meetsitaram/reindeer/reports/fusion/fusion_back.png

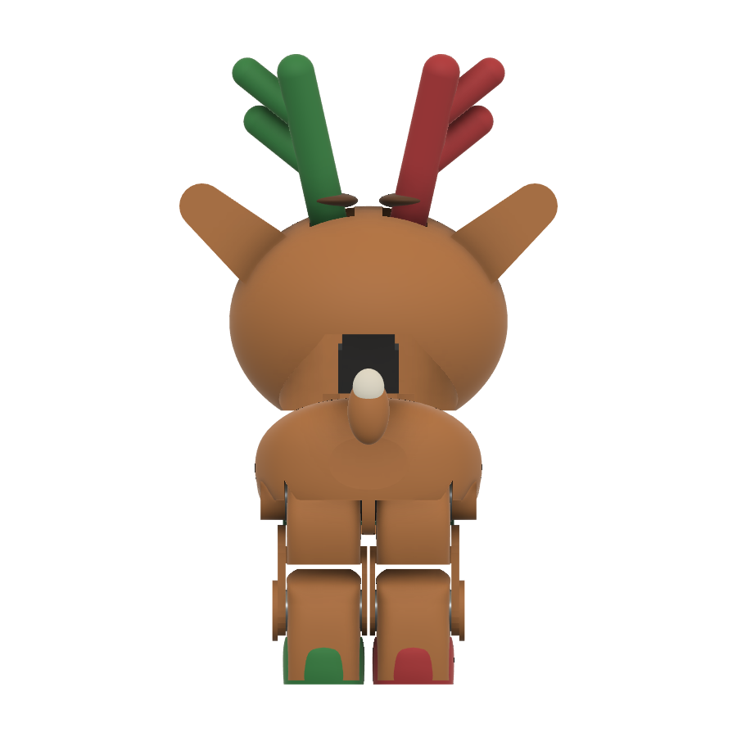
reports/fusion/fusion_back.png
