meetsitaram/reindeer/reports/fusion/fusion_pose_r34.png

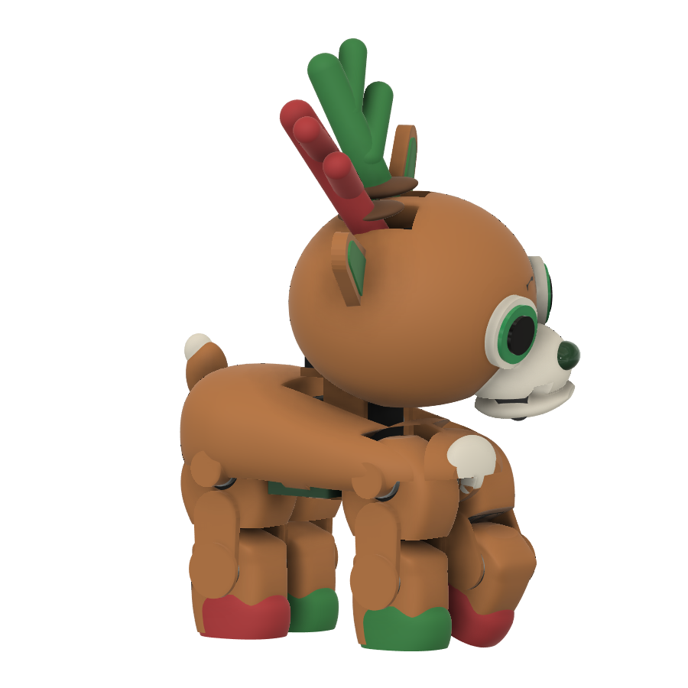
reports/fusion/fusion_pose_r34.png
