meetsitaram/reindeer/reports/fusion/fusion_r34.png

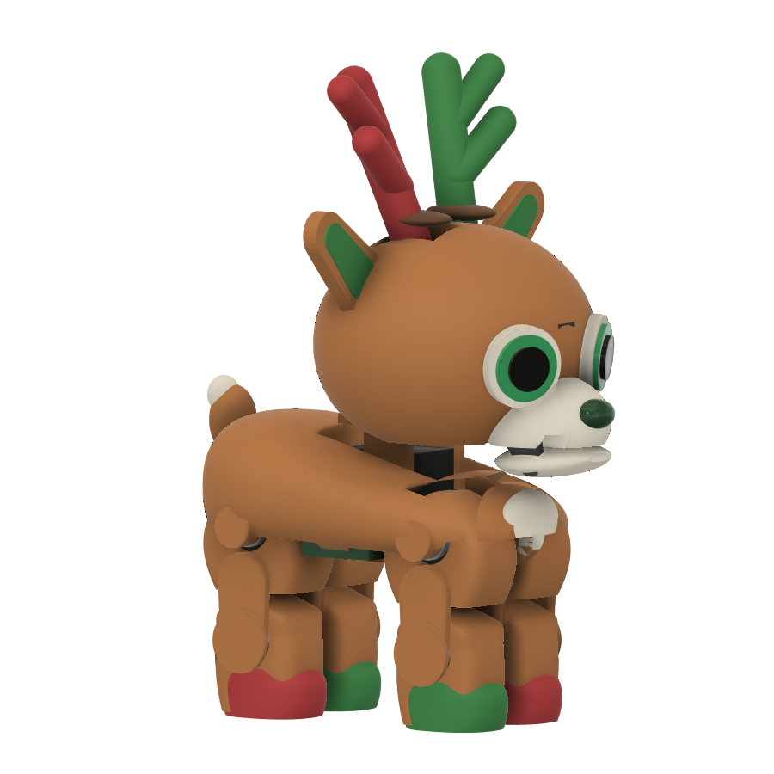
reports/fusion/fusion_r34.png
