meetsitaram/reindeer/reports/fusion/fusion_side.png

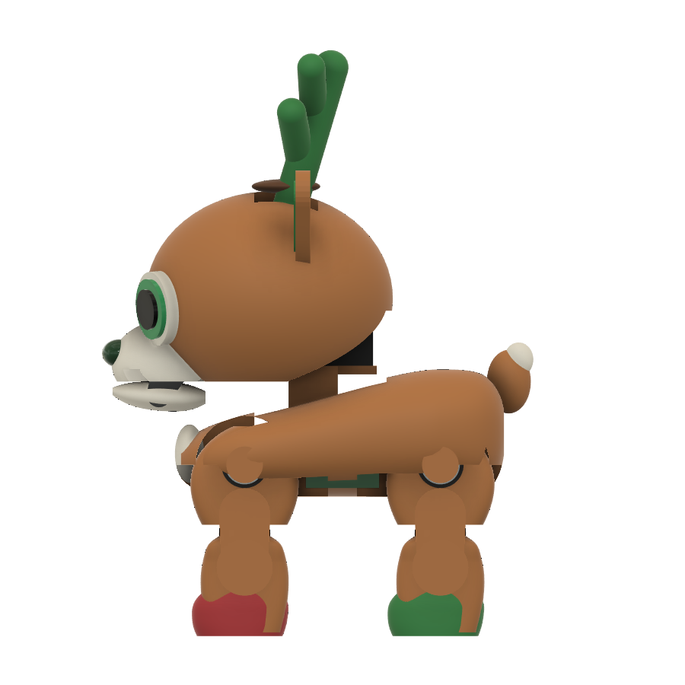
reports/fusion/fusion_side.png
