meetsitaram/reindeer/reports/fusion/fusion_top.png

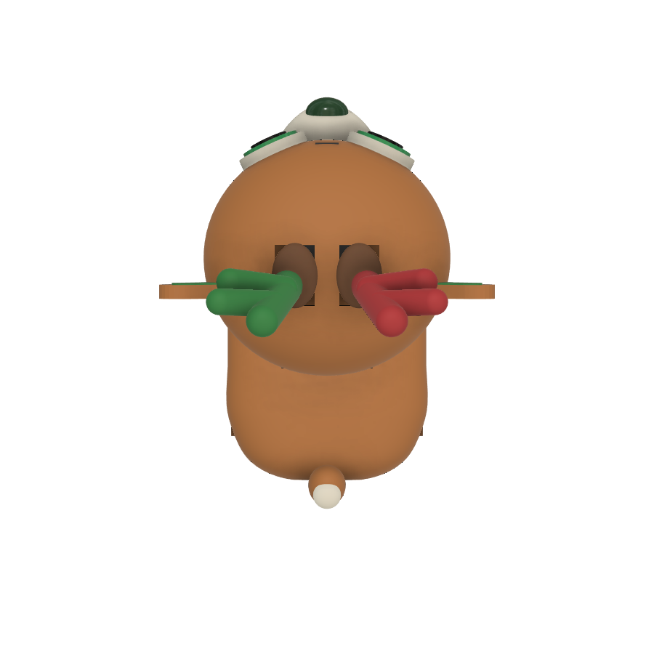
reports/fusion/fusion_top.png
