meetsitaram/reindeer/reports/motion_frames/all.png

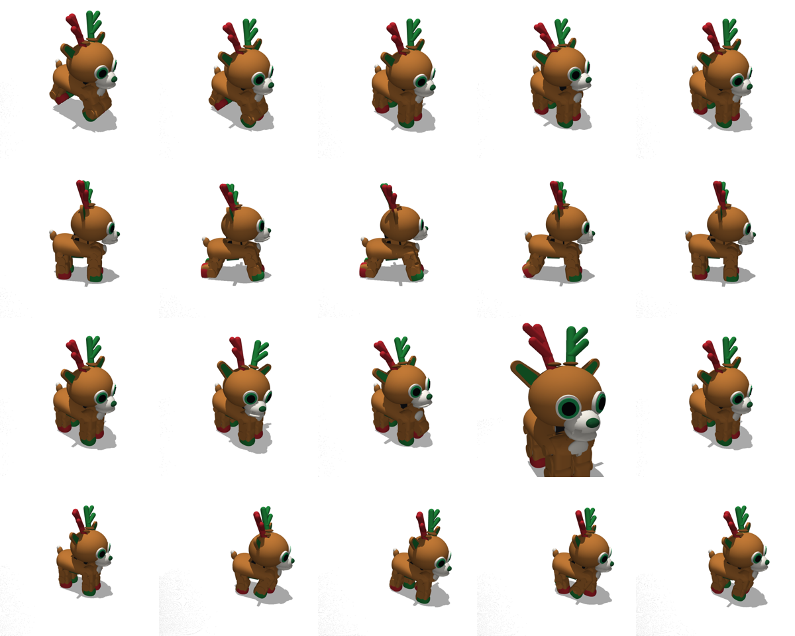
reports/motion_frames/all.png
