meetsitaram/reindeer/reports/motion_frames/motions.png

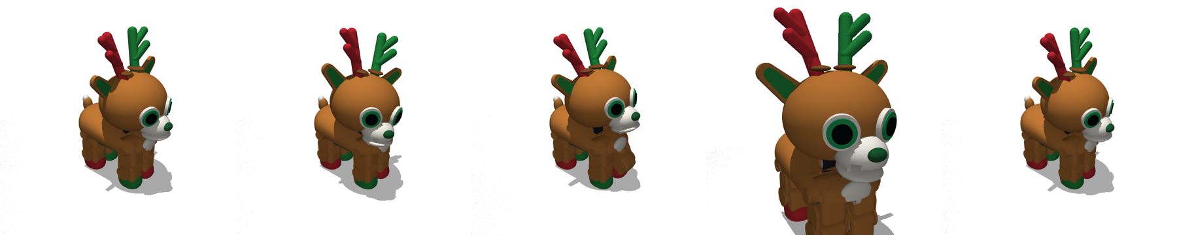
reports/motion_frames/motions.png
