meetsitaram/reindeer/reports/motion_frames/sit.png

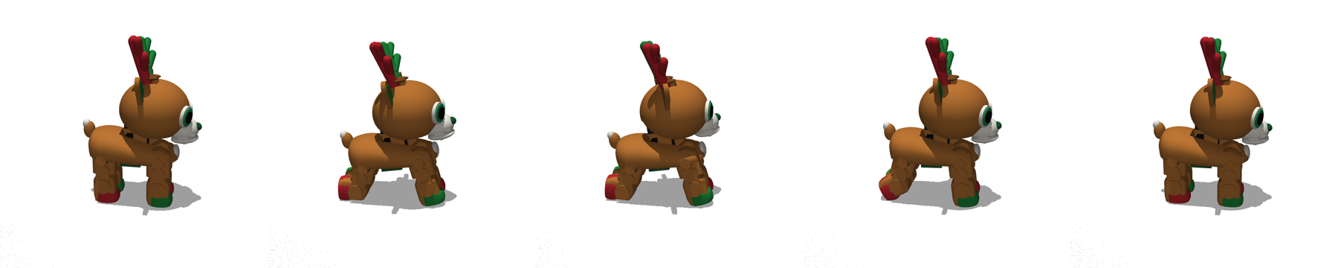
reports/motion_frames/sit.png
