meetsitaram/reindeer/reports/motion_frames/stand_up.png

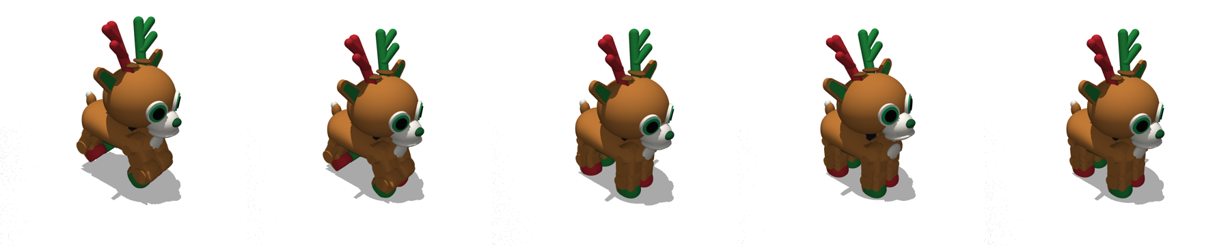
reports/motion_frames/stand_up.png
