meetsitaram/reindeer/reports/motion_frames/walk.png

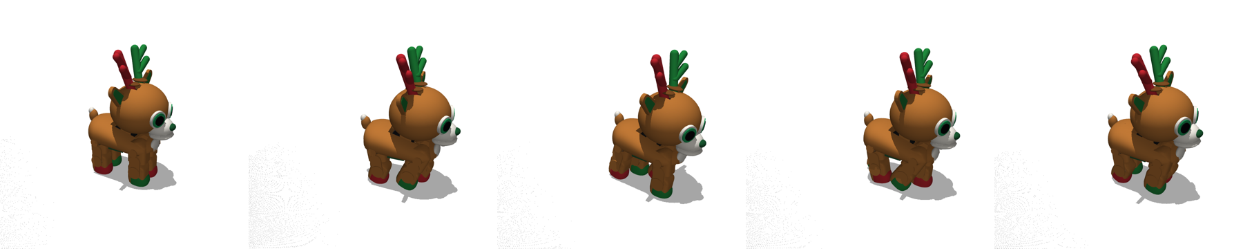
reports/motion_frames/walk.png
