meetsitaram/reindeer/reports/poses.png

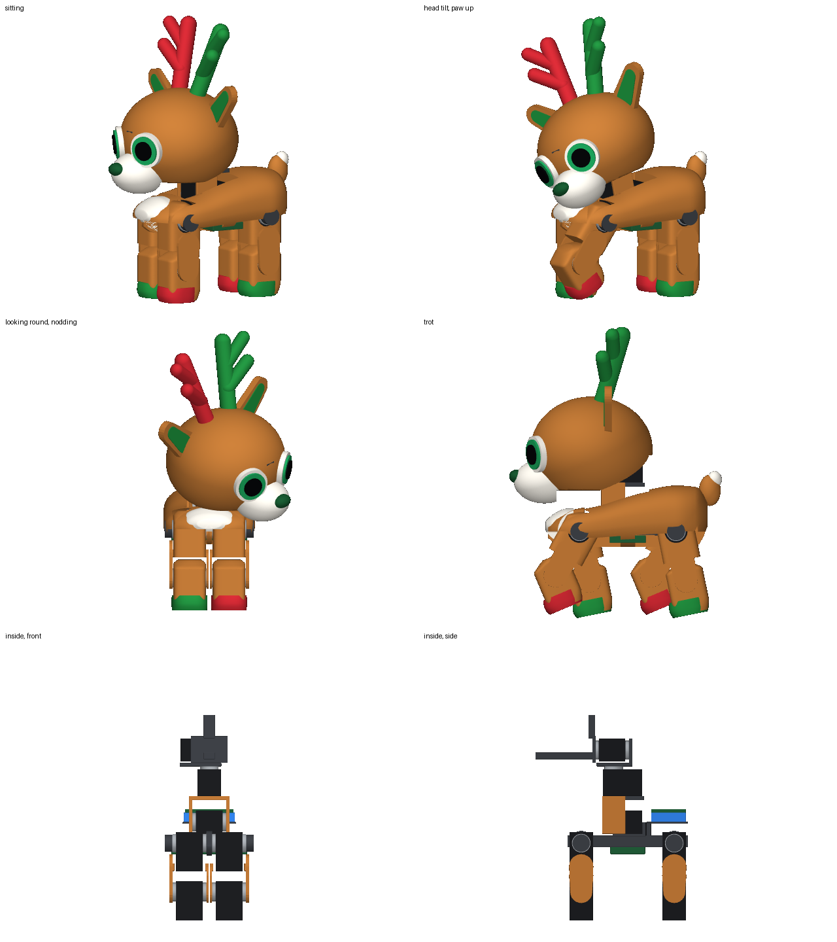
reports/poses.png
