meetsitaram/reindeer/reports/round8.png

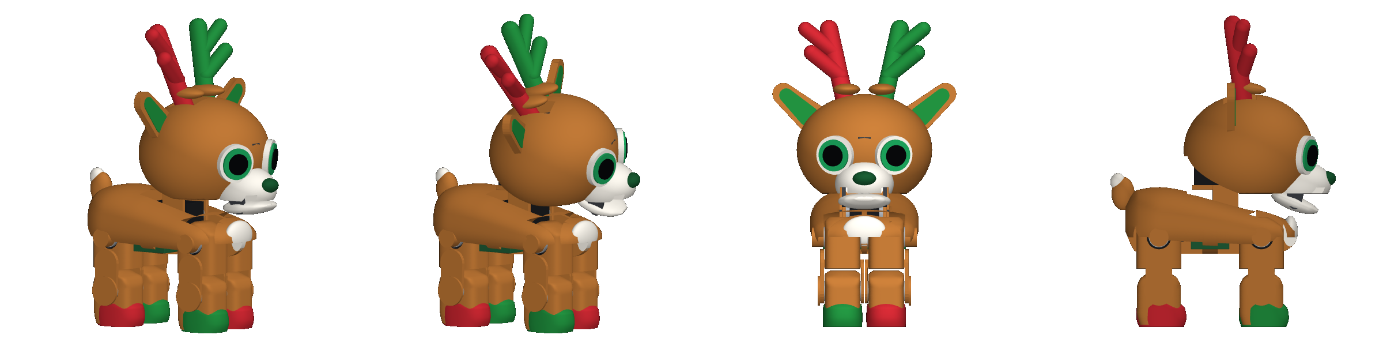
reports/round8.png
