meetsitaram/reindeer/docs/parts_layout.png

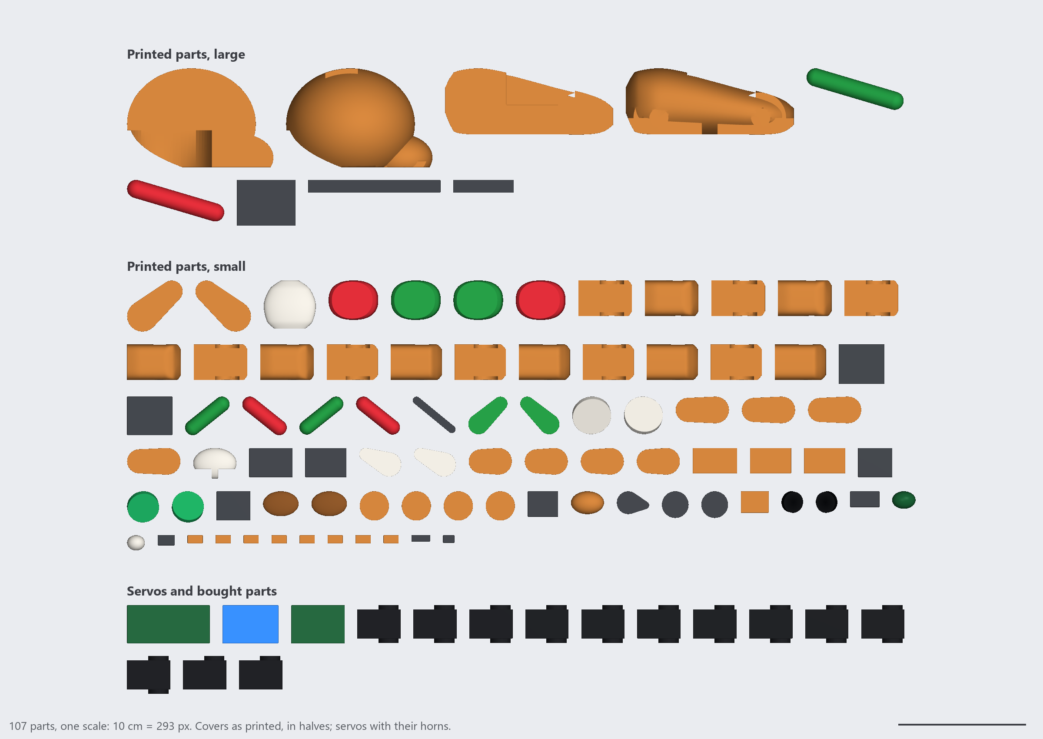
docs/parts_layout.png
