meetsitaram/reindeer/cad/reindeer.step

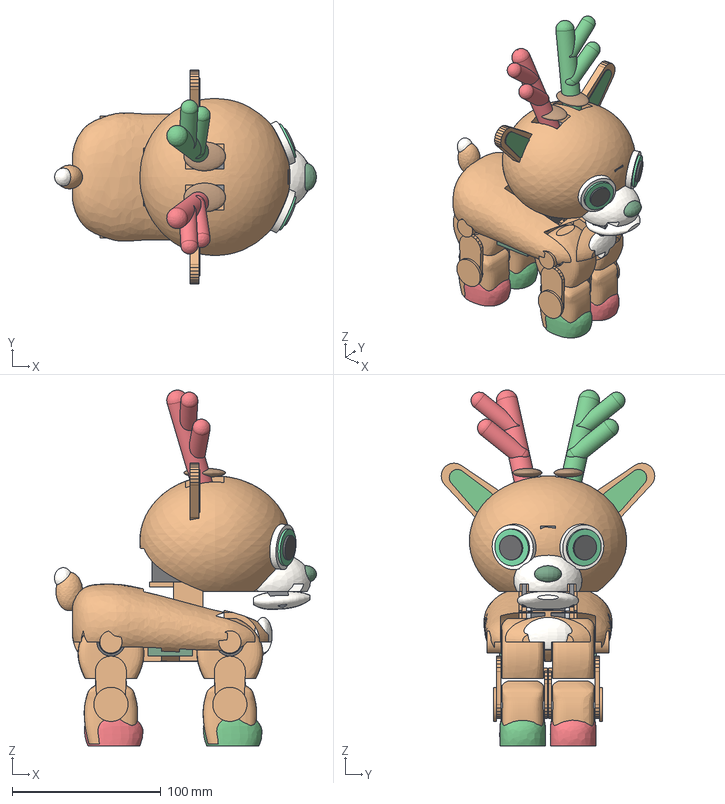
[picture p14: CAD file, 2026-11-06]
cad/reindeer.step
176.3 x 143.8 x 239.5 mm
