meetsitaram/reindeer/prints/antlers/antler_horn_plate.stl

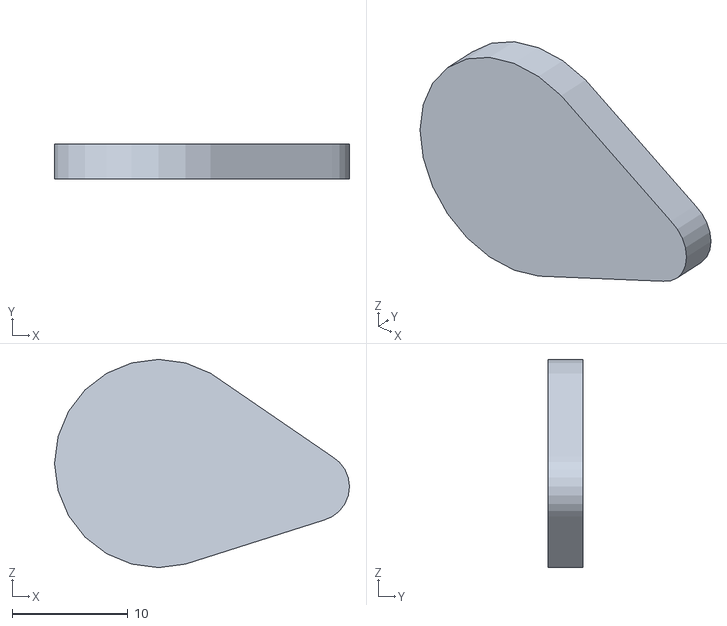
[picture p15: CAD file, 2026-11-06]
prints/antlers/antler_horn_plate.stl
25.5 x 3.00 x 18.0
