meetsitaram/reindeer/prints/body/bib.stl

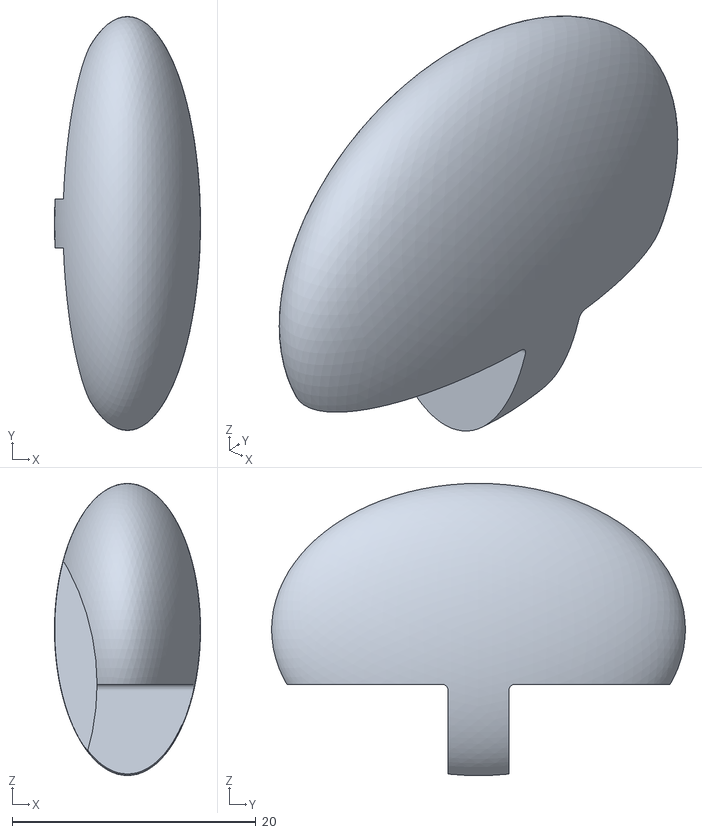
[picture p16: CAD file, 2026-11-06]
prints/body/bib.stl
12.0 x 34.0 x 24.0
