meetsitaram/reindeer/prints/head/head_face_post.stl

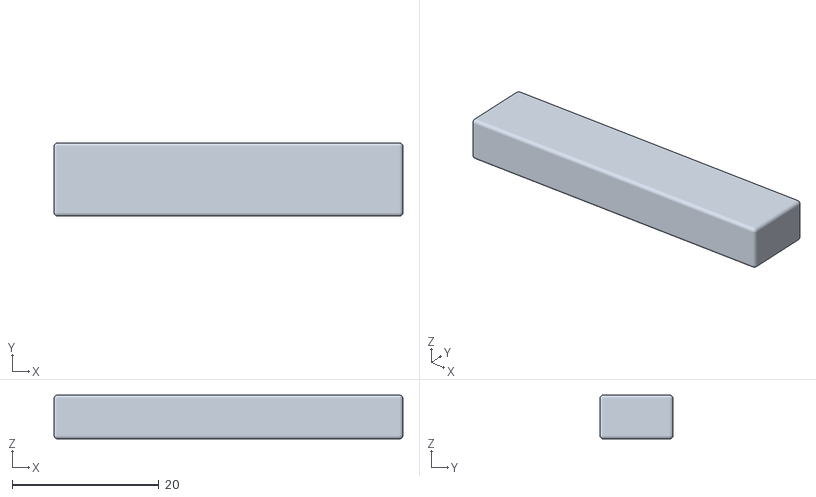
[picture p17: CAD file, 2026-11-06]
prints/head/head_face_post.stl
47.6 x 10.0 x 6.00
