meetsitaram/reindeer/prints/jaw/R_jaw_plate.stl

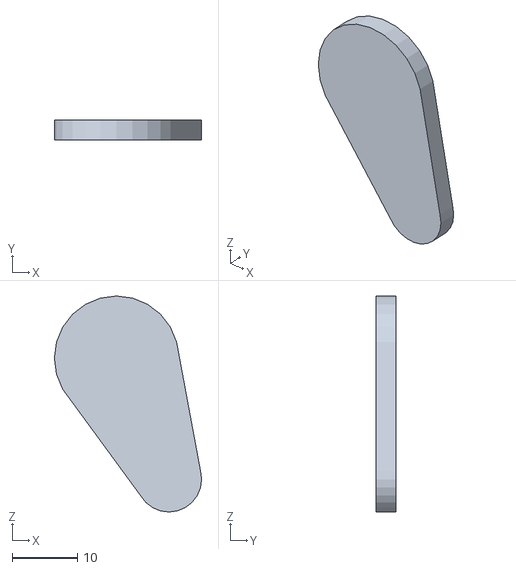
[picture p18: CAD file, 2026-11-06]
prints/jaw/R_jaw_plate.stl
22.5 x 3.00 x 33.0
