meetsitaram/reindeer/prints/L_front_shin/L_front_shin.stl

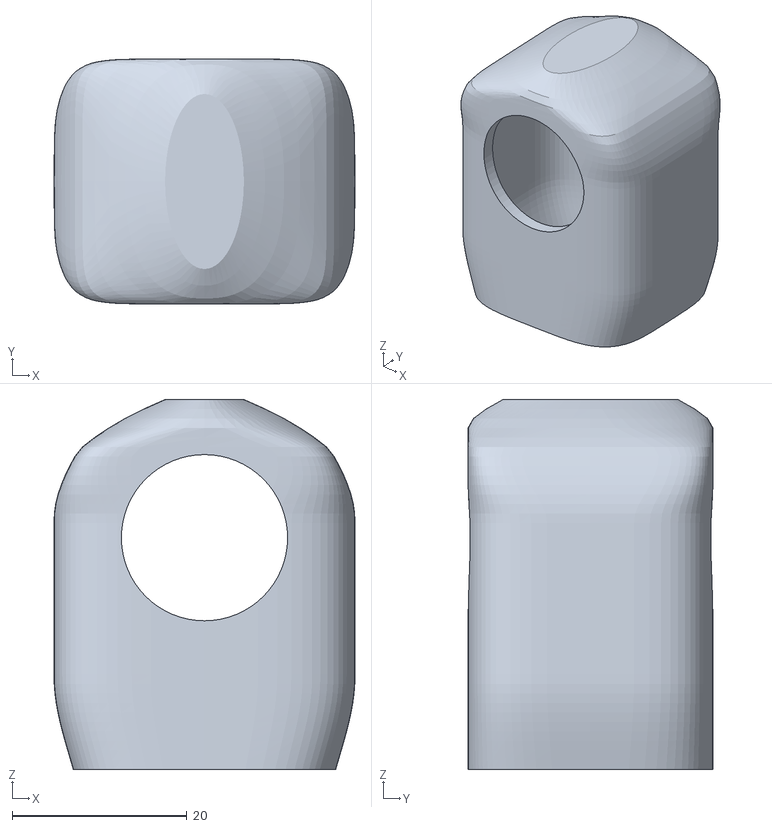
[picture p19: CAD file, 2026-11-06]
prints/L_front_shin/L_front_shin.stl
34.4 x 28.0 x 42.3
