meetsitaram/reindeer/prints/L_front_thigh/L_front_knee_plate.stl

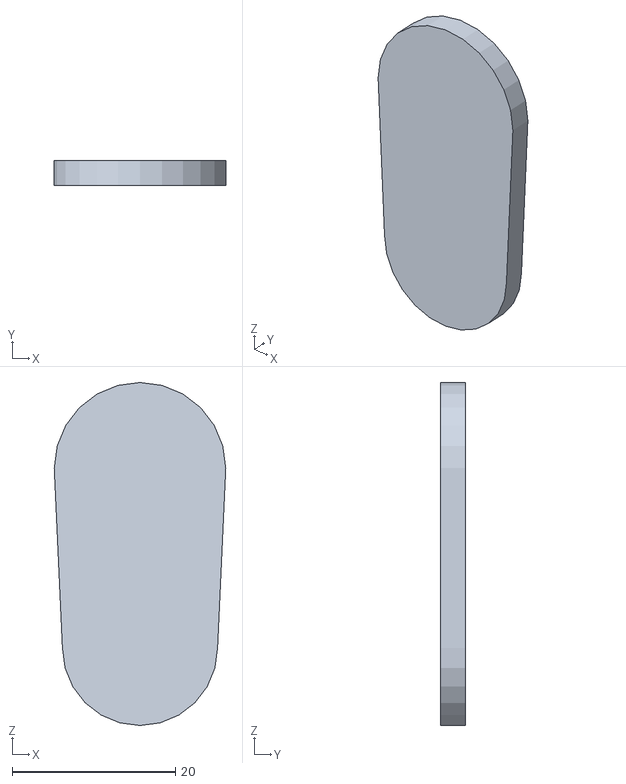
[picture p20: CAD file, 2026-11-06]
prints/L_front_thigh/L_front_knee_plate.stl
21.0 x 3.00 x 42.0
