meetsitaram/reindeer/prints/neck/neck_yaw_seat.stl

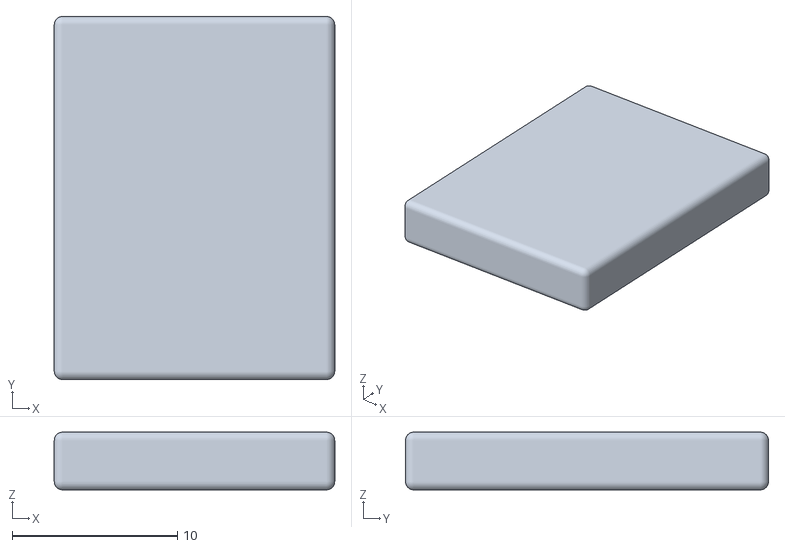
[picture p21: CAD file, 2026-11-06]
prints/neck/neck_yaw_seat.stl
17.0 x 22.0 x 3.50
