meetsitaram/reindeer/prints/R_front_thigh/R_front_thigh.stl

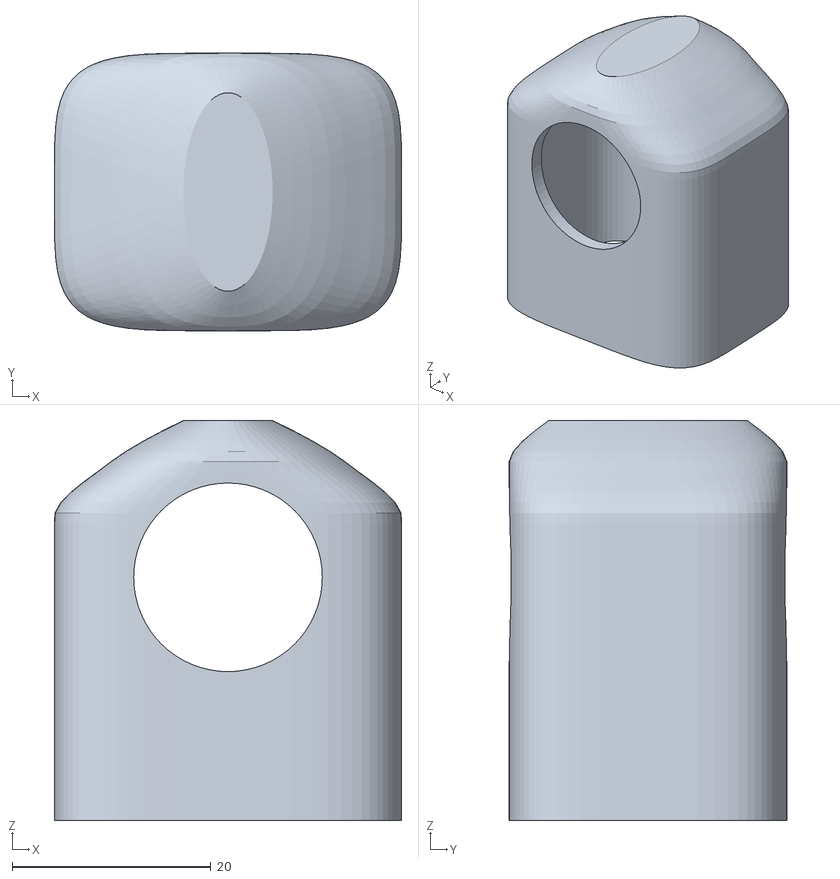
[picture p22: CAD file, 2026-11-06]
prints/R_front_thigh/R_front_thigh.stl
35.0 x 28.0 x 40.3
