meetsitaram/reindeer/prints/R_rear_shin/R_rear_hoof.stl

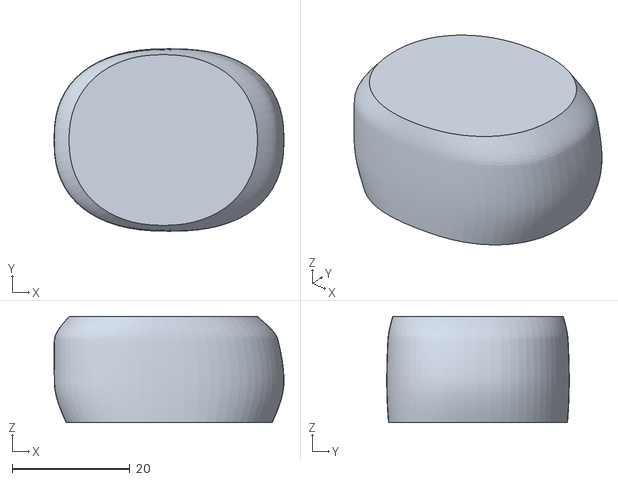
[picture p23: CAD file, 2026-11-06]
prints/R_rear_shin/R_rear_hoof.stl
39.0 x 31.0 x 18.0
