meetsitaram/reindeer/prints/R_rear_thigh/R_rear_knee_outer_tab.stl

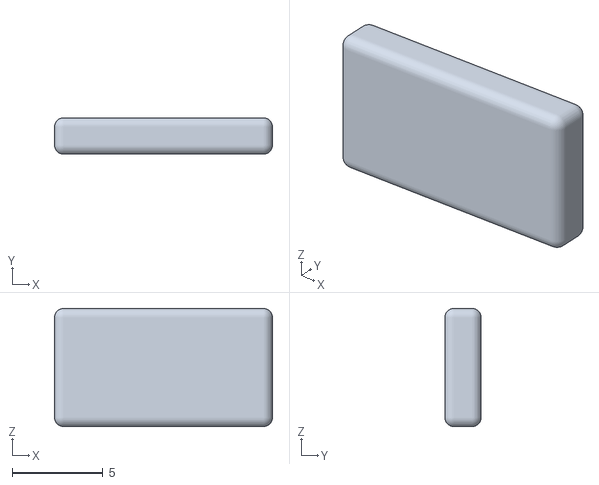
[picture p24: CAD file, 2026-11-06]
prints/R_rear_thigh/R_rear_knee_outer_tab.stl
12.0 x 2.00 x 6.50
