meetsitaram/reindeer/prints/yawlink/roll_rear_wall.stl

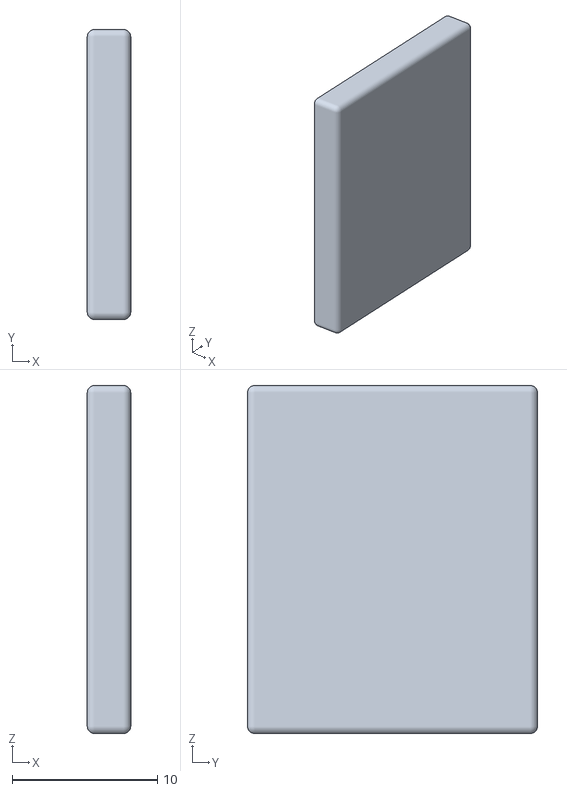
[picture p25: CAD file, 2026-11-06]
prints/yawlink/roll_rear_wall.stl
3.00 x 20.0 x 24.0
