meetsitaram/reindeer/prints/antlers/antler_bar_arm.stl

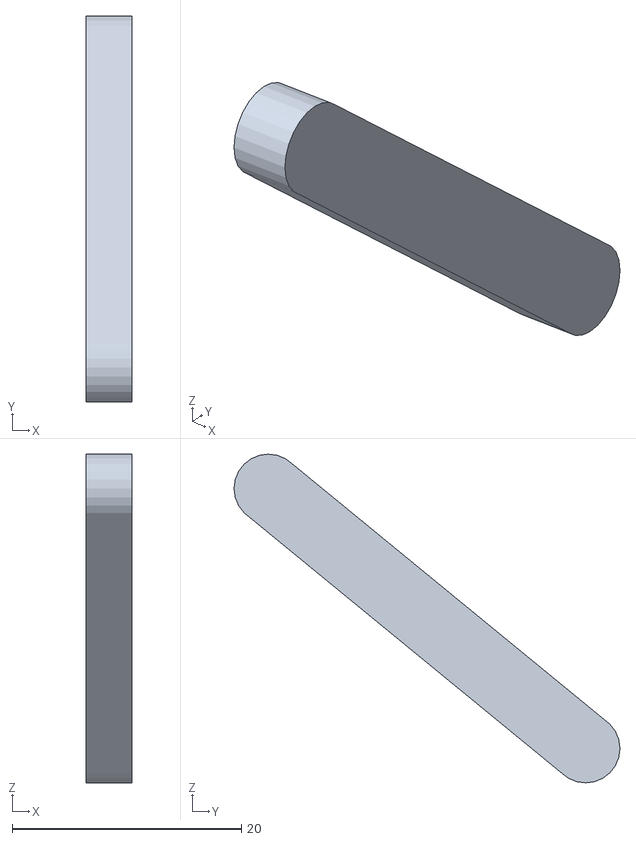
[picture p26: CAD file, 2026-11-06]
prints/antlers/antler_bar_arm.stl
4.00 x 33.7 x 28.7
