meetsitaram/reindeer/prints/body/R_front_hip_boss.stl

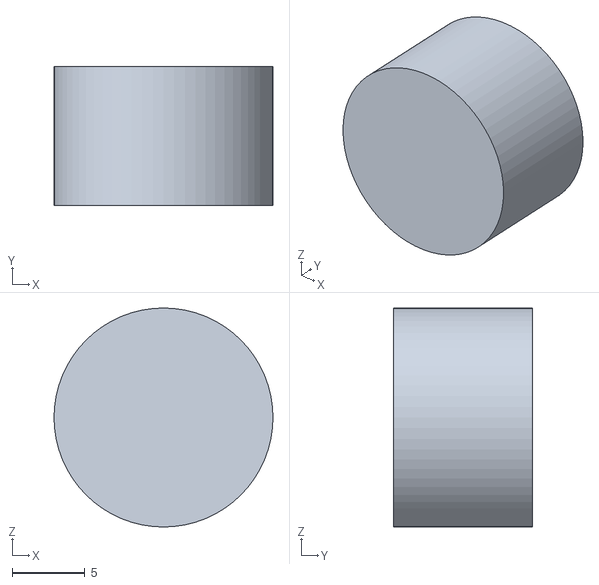
[picture p27: CAD file, 2026-11-06]
prints/body/R_front_hip_boss.stl
15.0 x 9.50 x 15.0
