meetsitaram/reindeer/prints/head/L_ear.stl

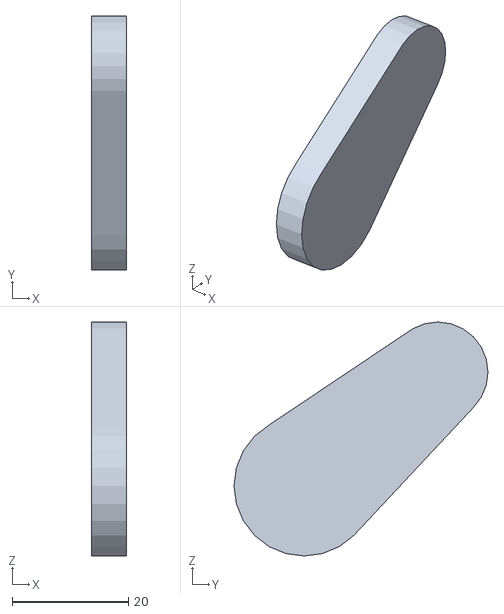
[picture p28: CAD file, 2026-11-06]
prints/head/L_ear.stl
6.00 x 43.7 x 40.3
