meetsitaram/reindeer/prints/jaw/jaw.stl

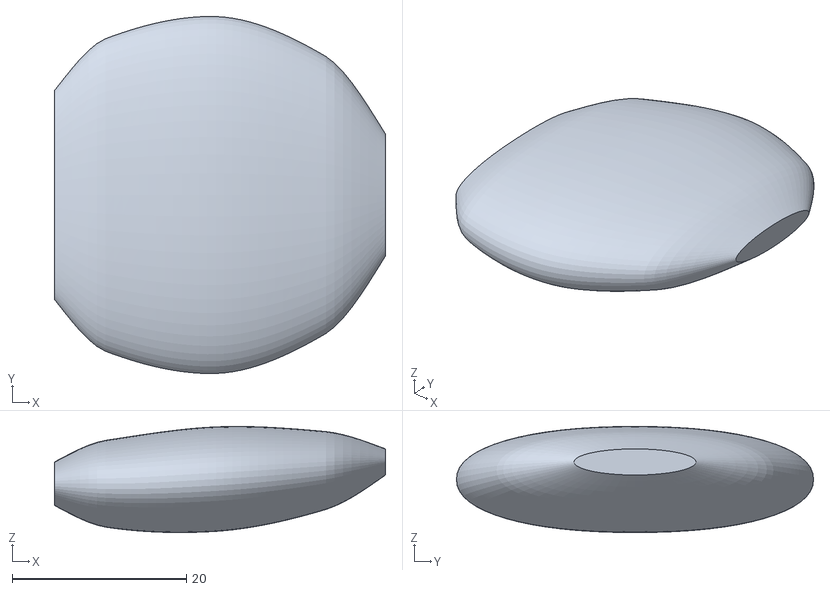
[picture p29: CAD file, 2026-11-06]
prints/jaw/jaw.stl
38.0 x 41.0 x 12.2
