meetsitaram/reindeer/prints/L_front_thigh/L_front_knee_inner_tab.stl

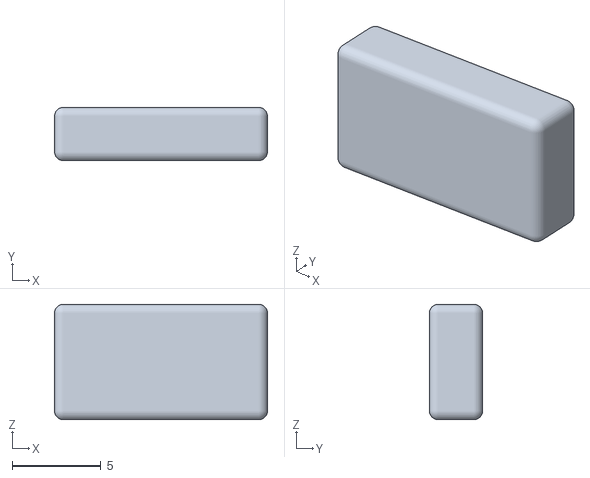
[picture p30: CAD file, 2026-11-06]
prints/L_front_thigh/L_front_knee_inner_tab.stl
12.0 x 3.00 x 6.50
