meetsitaram/reindeer/prints/neck/neck_bridge.stl

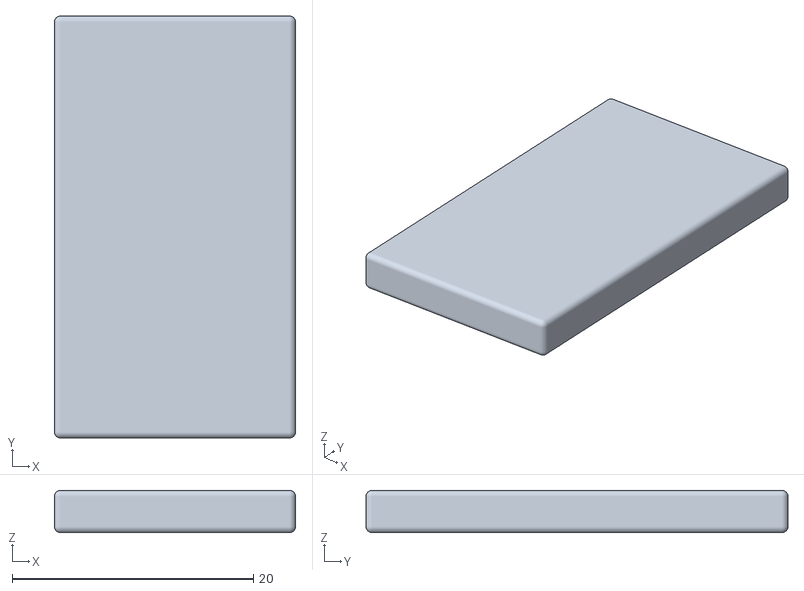
[picture p31: CAD file, 2026-11-06]
prints/neck/neck_bridge.stl
20.0 x 35.0 x 3.50
