meetsitaram/reindeer/prints/yawlink/yaw_plate.stl

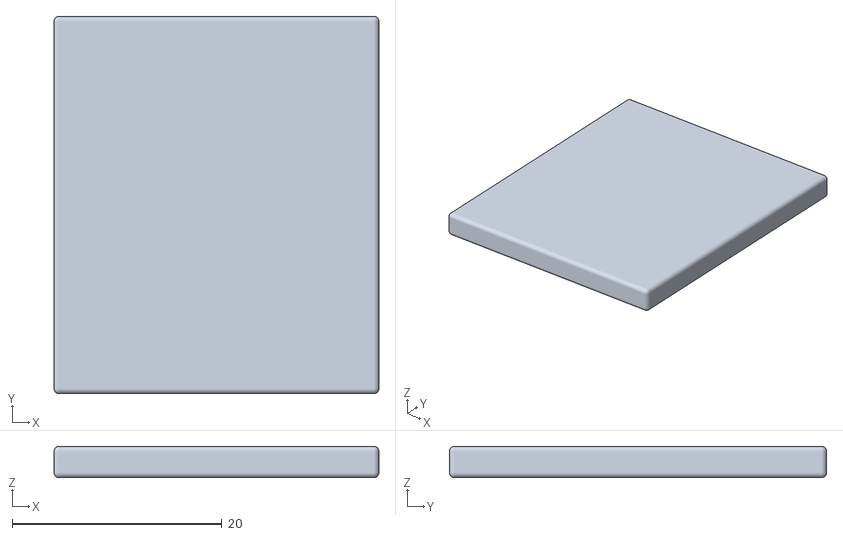
[picture p32: CAD file, 2026-11-06]
prints/yawlink/yaw_plate.stl
31.0 x 36.0 x 3.00
