meetsitaram/reindeer/prints/antlers/L_antler_tine_1.stl

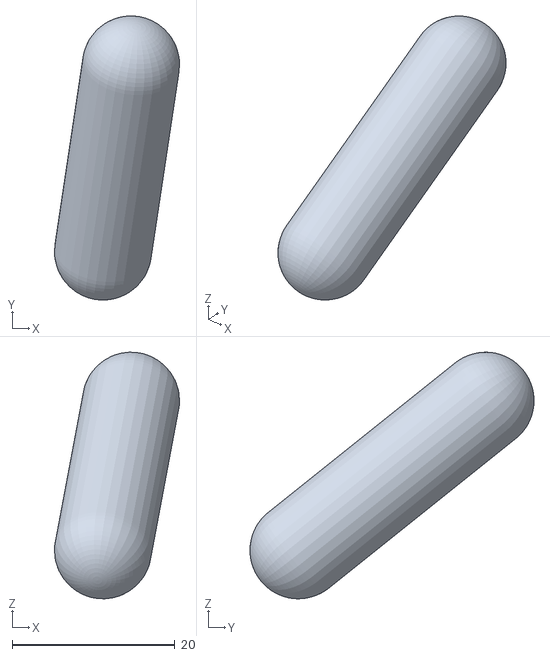
[picture p33: CAD file, 2026-11-06]
prints/antlers/L_antler_tine_1.stl
15.4 x 34.9 x 30.3
