meetsitaram/reindeer/prints/body/tail_tip.stl

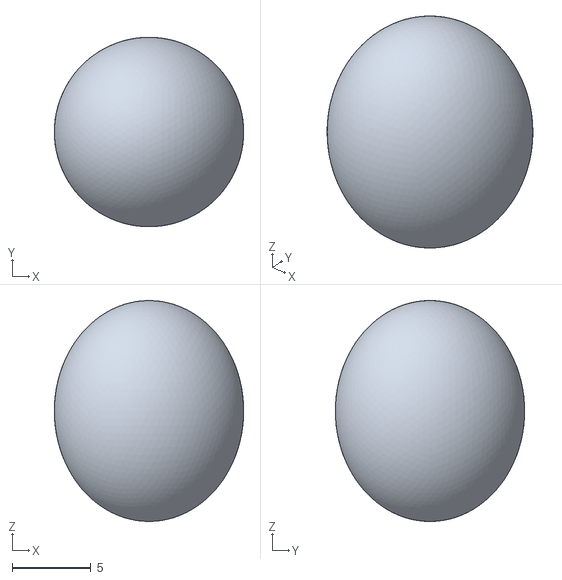
[picture p34: CAD file, 2026-11-06]
prints/body/tail_tip.stl
12.0 x 12.0 x 14.0
