meetsitaram/reindeer/prints/head/jaw_cradle_post.stl

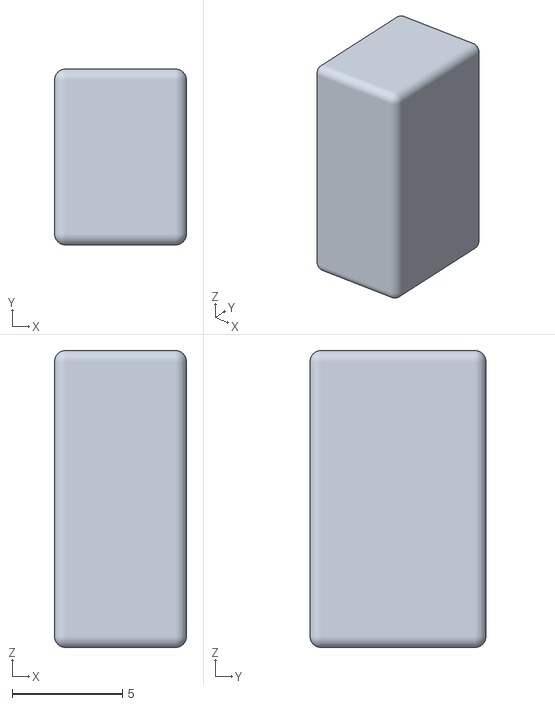
[picture p35: CAD file, 2026-11-06]
prints/head/jaw_cradle_post.stl
6.00 x 8.00 x 13.5
