meetsitaram/reindeer/prints/neck/neck_horn_plate.stl

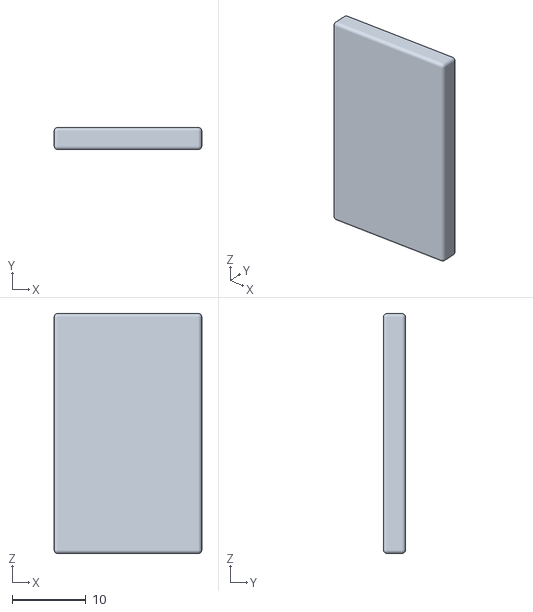
[picture p36: CAD file, 2026-11-06]
prints/neck/neck_horn_plate.stl
20.0 x 3.00 x 32.5
