meetsitaram/reindeer/prints/R_front_thigh/R_front_knee_inner_plate.stl

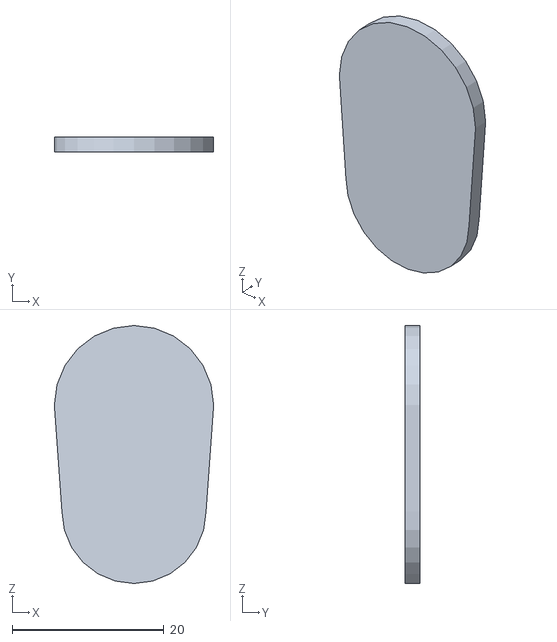
[picture p37: CAD file, 2026-11-06]
prints/R_front_thigh/R_front_knee_inner_plate.stl
21.0 x 2.00 x 34.0
