meetsitaram/reindeer/prints/antlers/R_antler_tine_2.stl

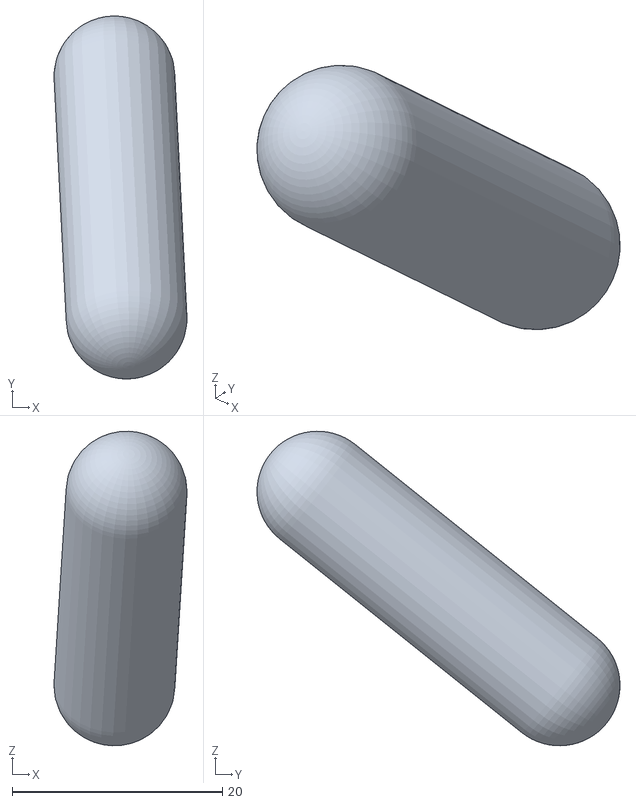
[picture p38: CAD file, 2026-11-06]
prints/antlers/R_antler_tine_2.stl
12.6 x 34.5 x 29.9
