meetsitaram/reindeer/prints/body/tail.stl

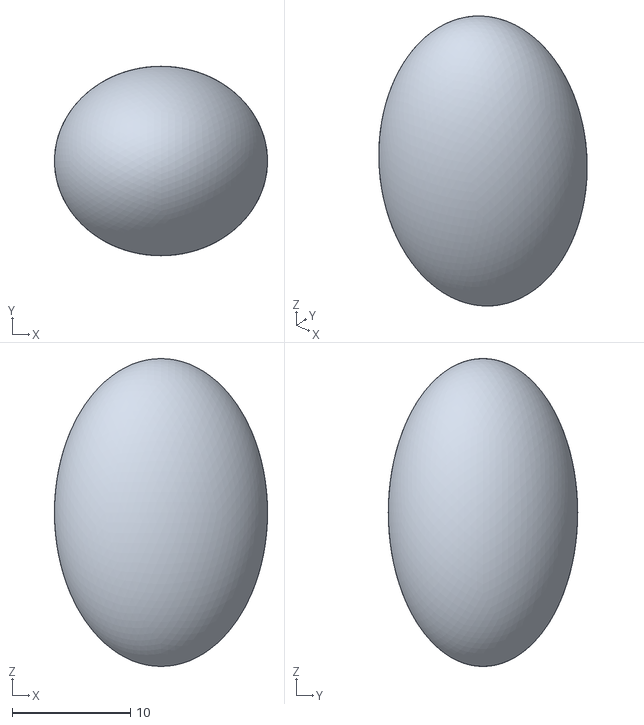
[picture p39: CAD file, 2026-11-06]
prints/body/tail.stl
18.0 x 16.0 x 26.0
