meetsitaram/reindeer/prints/head/R_eye_rim.stl

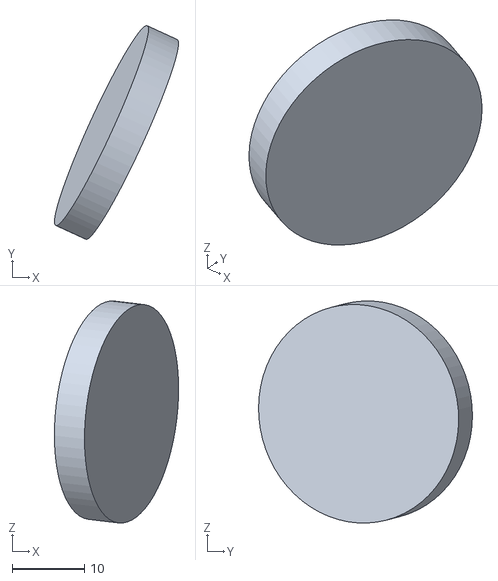
[picture p40: CAD file, 2026-11-06]
prints/head/R_eye_rim.stl
17.2 x 29.5 x 30.7
