meetsitaram/reindeer/prints/jaw/tongue.stl

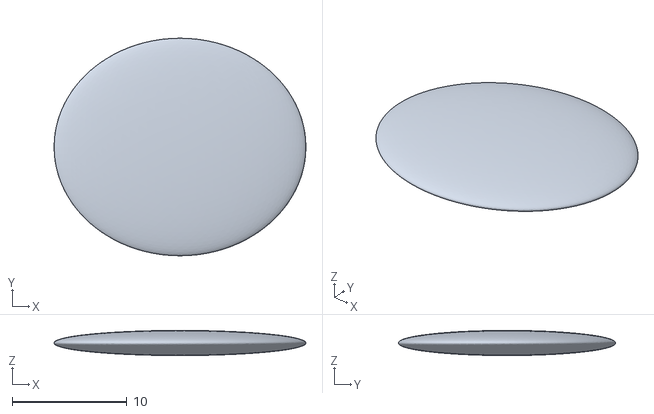
[picture p41: CAD file, 2026-11-06]
prints/jaw/tongue.stl
22.0 x 19.0 x 2.20
