meetsitaram/reindeer/prints/antlers/L_antler_burr.stl

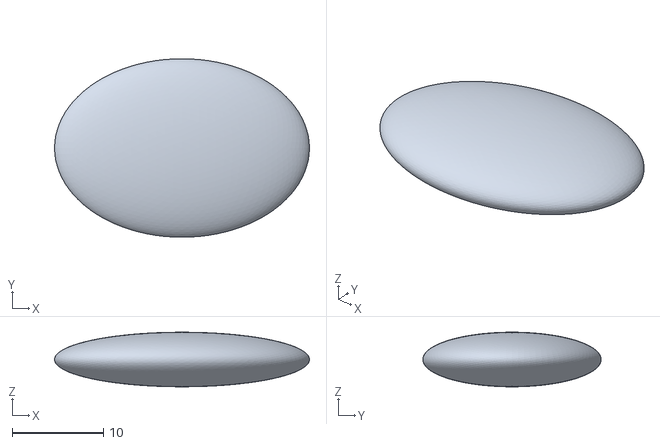
[picture p42: CAD file, 2026-11-06]
prints/antlers/L_antler_burr.stl
28.0 x 19.6 x 6.00
