meetsitaram/reindeer/prints/body/battery_tray.stl

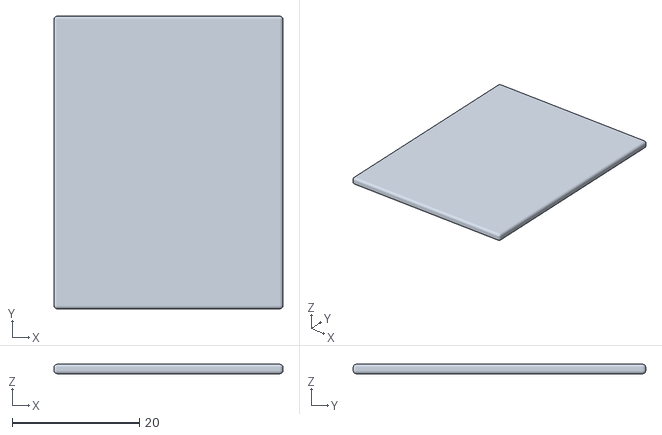
[picture p43: CAD file, 2026-11-06]
prints/body/battery_tray.stl
36.0 x 46.0 x 1.50
