meetsitaram/reindeer/prints/head/R_eye_pupil.stl

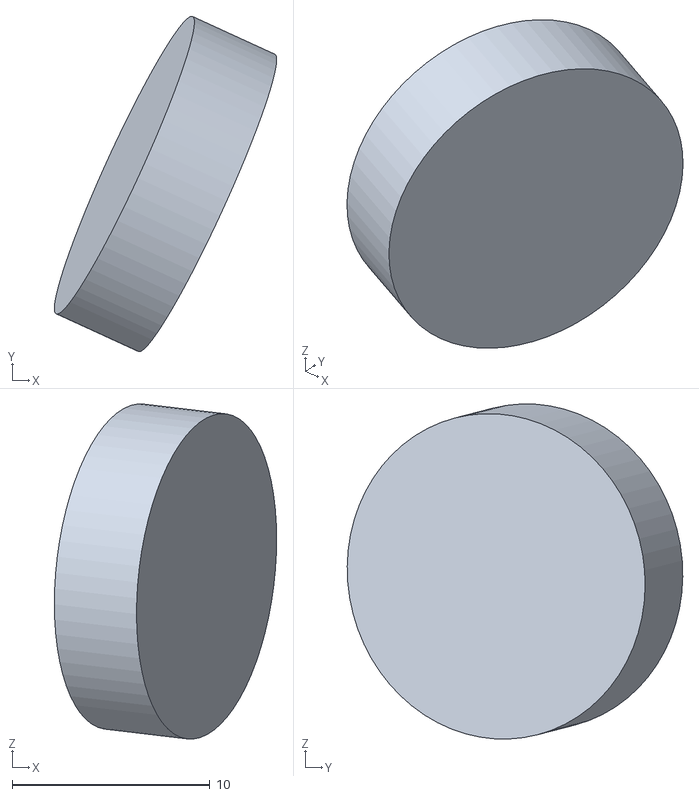
[picture p44: CAD file, 2026-11-06]
prints/head/R_eye_pupil.stl
11.2 x 17.0 x 16.9
