meetsitaram/reindeer/prints/body/keel_front_disc.stl

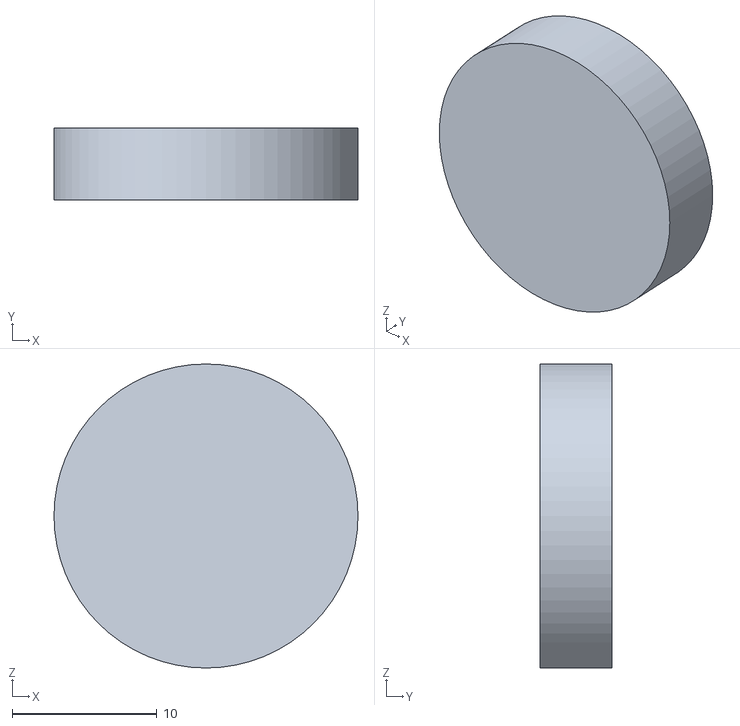
[picture p45: CAD file, 2026-11-06]
prints/body/keel_front_disc.stl
21.0 x 5.00 x 21.0
