meetsitaram/reindeer/prints/head/head_bracket.stl

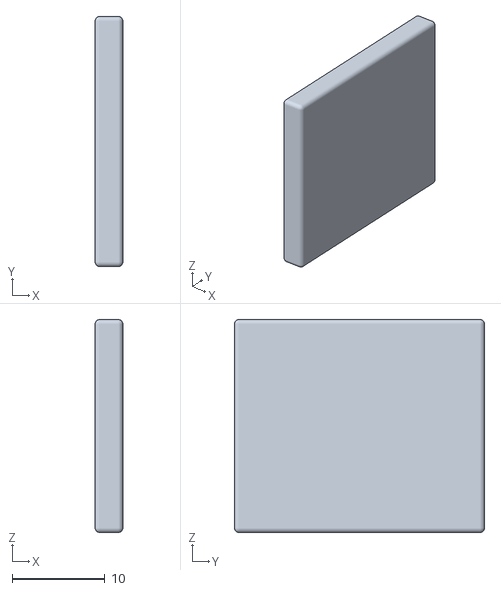
[picture p46: CAD file, 2026-11-06]
prints/head/head_bracket.stl
3.00 x 27.0 x 23.0
