meetsitaram/reindeer/prints/L_front_thigh/L_front_knee_cap.stl

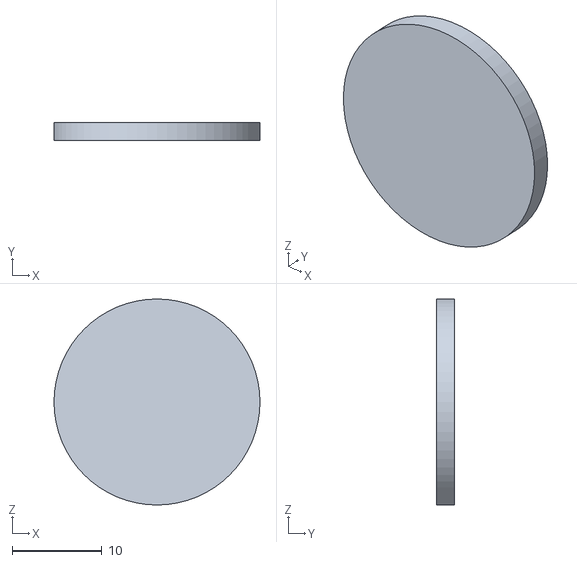
[picture p47: CAD file, 2026-11-06]
prints/L_front_thigh/L_front_knee_cap.stl
23.0 x 2.00 x 23.0
