meetsitaram/reindeer/prints/antlers/L_antler_beam.stl

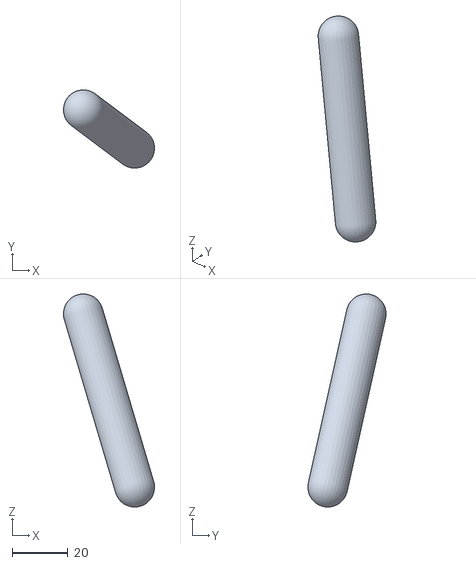
[picture p48: CAD file, 2026-11-06]
prints/antlers/L_antler_beam.stl
32.7 x 28.1 x 76.3
