meetsitaram/reindeer/prints/body/keel.stl

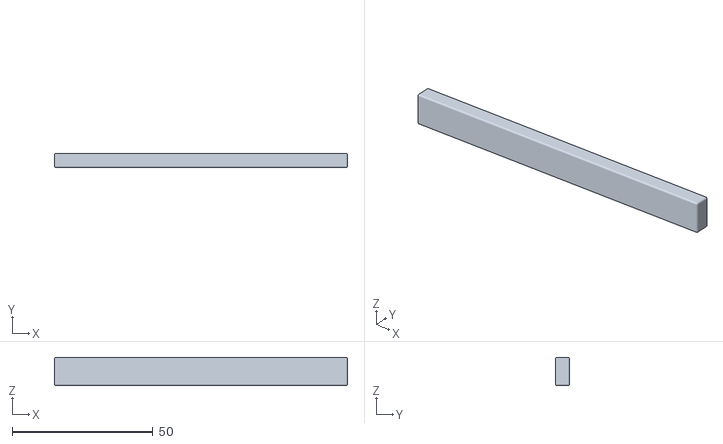
[picture p49: CAD file, 2026-11-06]
prints/body/keel.stl
104.0 x 5.00 x 10.0
