meetsitaram/reindeer/prints/body/neck_cradle_floor.stl

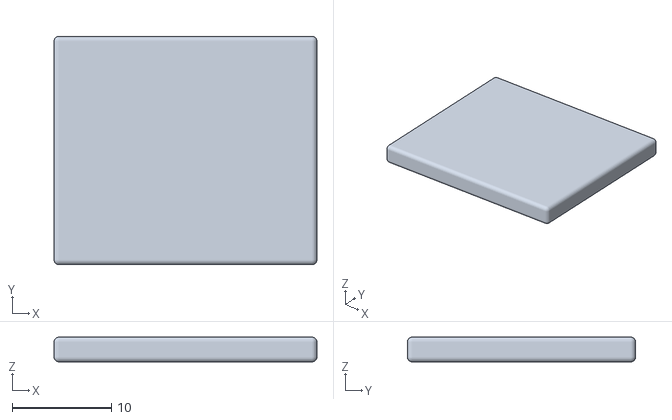
[picture p50: CAD file, 2026-11-06]
prints/body/neck_cradle_floor.stl
26.5 x 23.0 x 2.50
