meetsitaram/reindeer/prints/head/L_inner_ear.stl

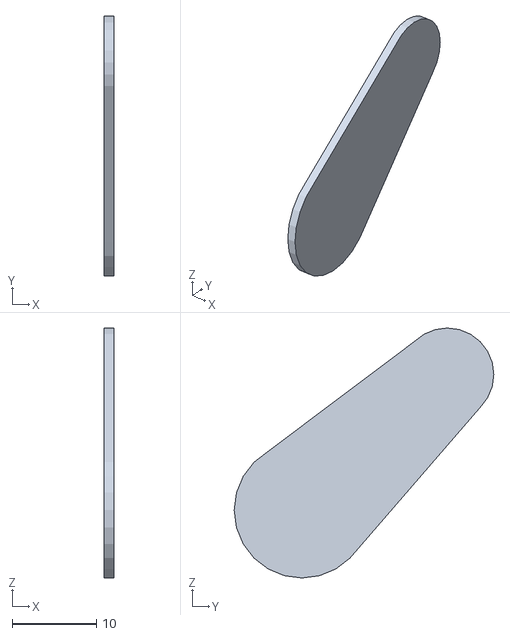
[picture p51: CAD file, 2026-11-06]
prints/head/L_inner_ear.stl
1.20 x 30.8 x 29.7
