meetsitaram/reindeer/prints/antlers/antler_bar.stl

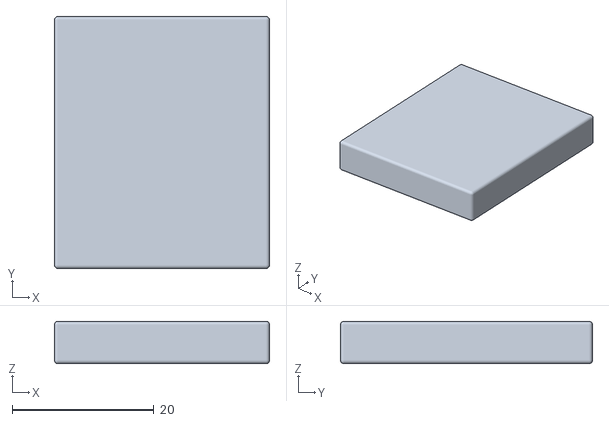
[picture p52: CAD file, 2026-11-06]
prints/antlers/antler_bar.stl
30.4 x 35.6 x 6.00
