meetsitaram/reindeer/prints/head/nose.stl

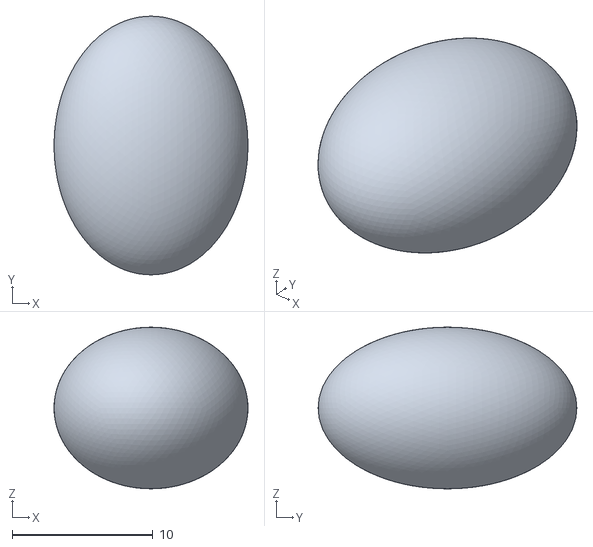
[picture p53: CAD file, 2026-11-06]
prints/head/nose.stl
13.8 x 18.4 x 11.5
