meetsitaram/reindeer/prints/body/body.stl

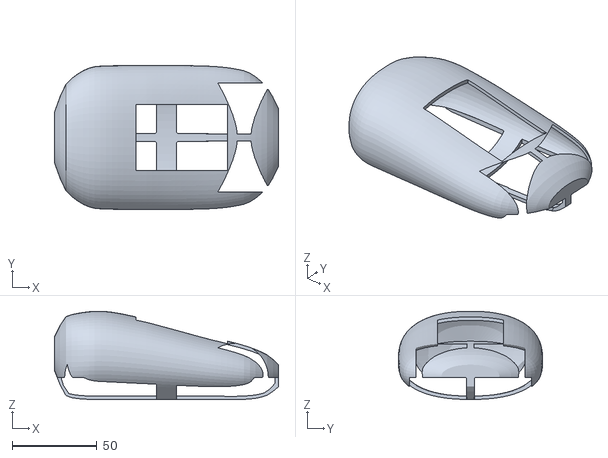
[picture p54: CAD file, 2026-11-06]
prints/body/body.stl
132.0 x 85.0 x 52.2
