meetsitaram/reindeer/prints/head/jaw_cradle.stl

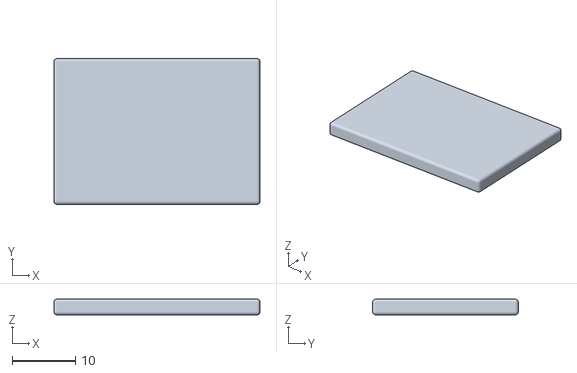
[picture p55: CAD file, 2026-11-06]
prints/head/jaw_cradle.stl
32.5 x 23.0 x 2.50
