meetsitaram/reindeer/prints/head/L_eye_iris.stl

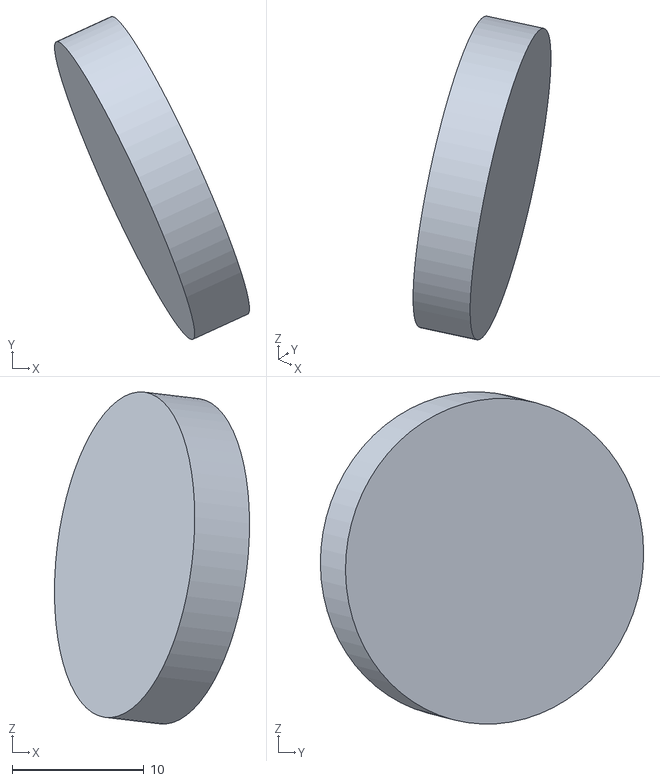
[picture p56: CAD file, 2026-11-06]
prints/head/L_eye_iris.stl
14.8 x 24.5 x 25.2
