meetsitaram/reindeer/prints/head/antler_cradle.stl

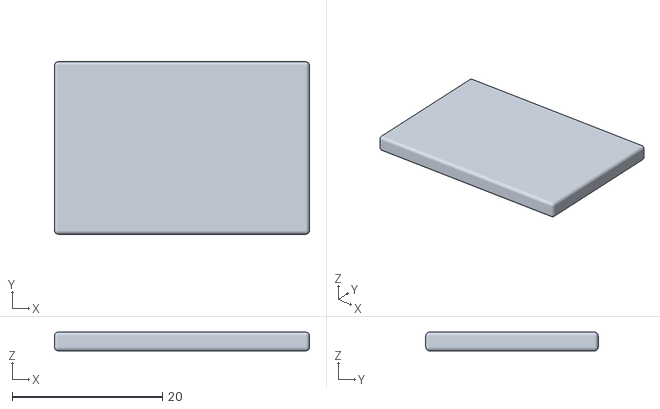
[picture p57: CAD file, 2026-11-06]
prints/head/antler_cradle.stl
34.0 x 23.0 x 2.50
