meetsitaram/reindeer/prints/body/battery_post.stl

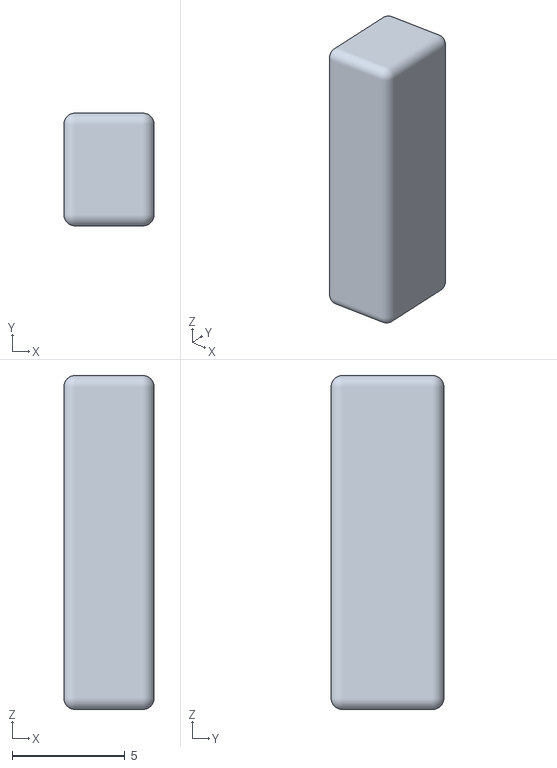
[picture p58: CAD file, 2026-11-06]
prints/body/battery_post.stl
4.00 x 5.00 x 14.8
