meetsitaram/reindeer/prints/head/muzzle.stl

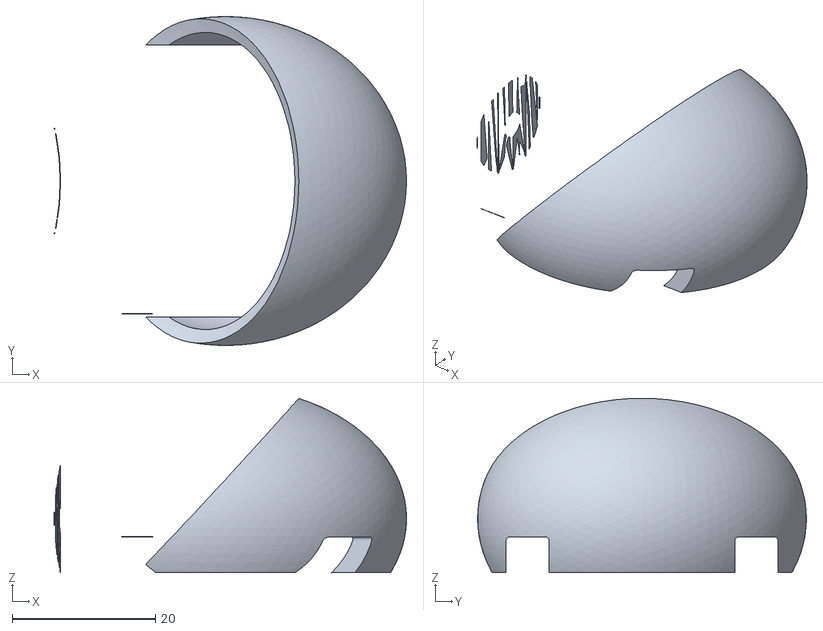
[picture p59: CAD file, 2026-11-06]
prints/head/muzzle.stl
49.2 x 46.0 x 24.4
