meetsitaram/reindeer/prints/body/neck_cradle_back.stl

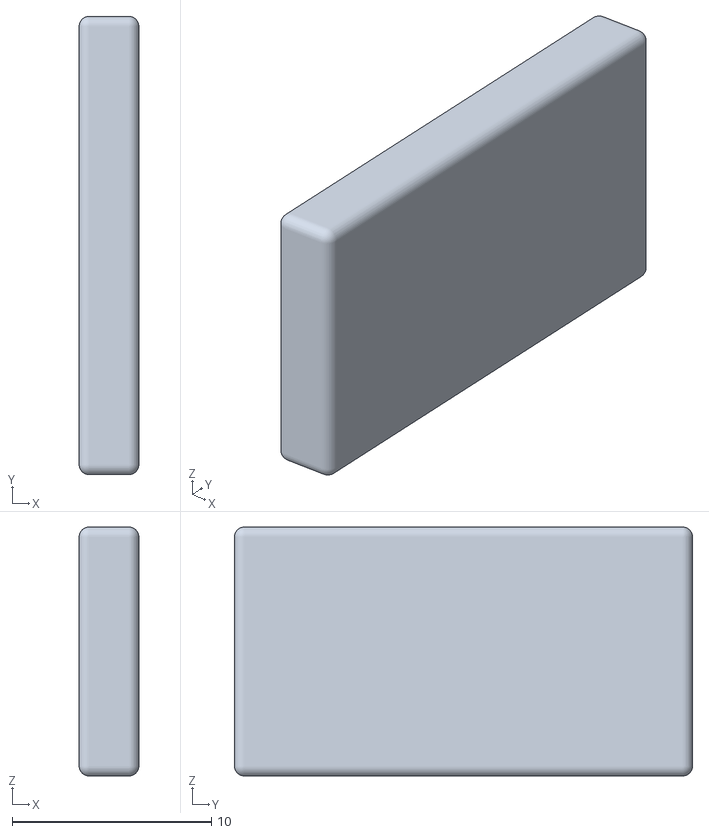
[picture p60: CAD file, 2026-11-06]
prints/body/neck_cradle_back.stl
3.00 x 23.0 x 12.5
