meetsitaram/reindeer/prints/head/cranium.stl

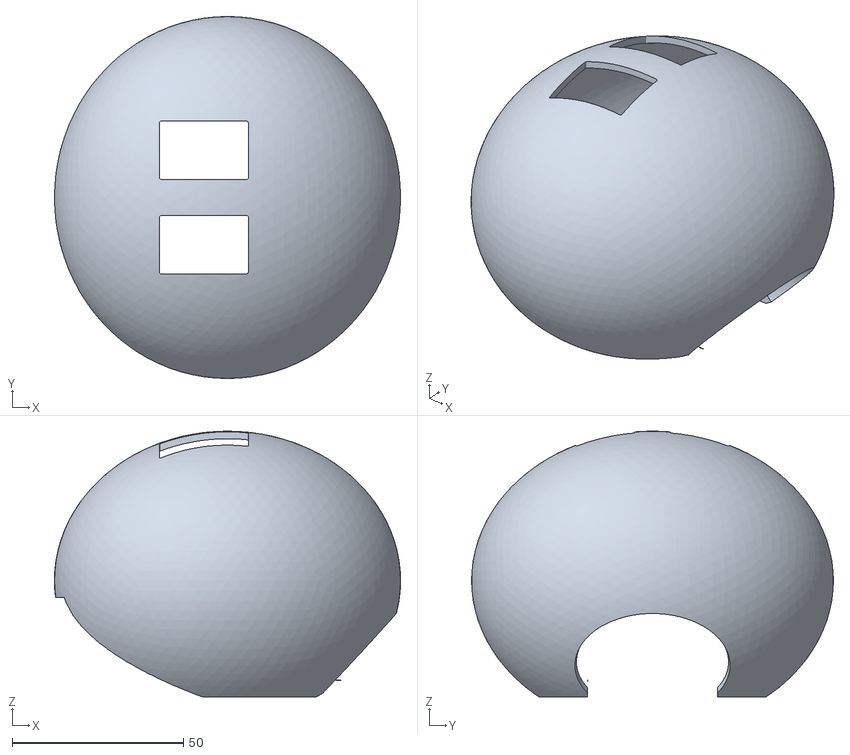
[picture p61: CAD file, 2026-11-06]
prints/head/cranium.stl
101.2 x 105.8 x 77.7
