meetsitaram/reindeer/prints/head/antler_cradle_post.stl

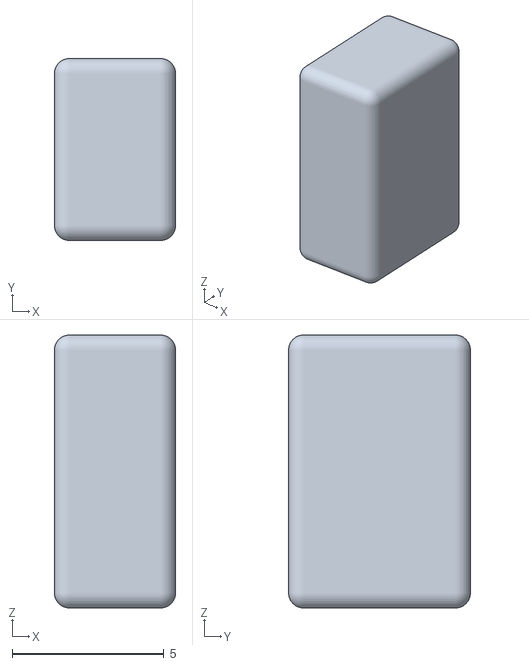
[picture p62: CAD file, 2026-11-06]
prints/head/antler_cradle_post.stl
4.00 x 6.00 x 9.00
