meetsitaram/reindeer/(list of files, cad)

Other CAD files:
prints/L_rear_shin/L_rear_shin.stl
prints/L_rear_thigh/L_rear_knee_plate.stl
prints/R_front_shin/R_front_shin.stl
prints/L_front_shin/L_front_hoof.stl
prints/L_rear_shin/L_rear_hoof.stl
prints/L_rear_thigh/L_rear_thigh.stl
prints/R_front_shin/R_front_hoof.stl
prints/R_front_thigh/R_front_knee_outer_tab.stl
prints/R_rear_shin/R_rear_shin.stl
prints/R_rear_thigh/R_rear_knee_plate.stl
prints/jaw/L_jaw_plate.stl
prints/L_front_thigh/L_front_thigh.stl
prints/L_rear_thigh/L_rear_knee_outer_tab.stl
prints/R_rear_thigh/R_rear_thigh.stl
prints/L_front_thigh/L_front_knee_outer_tab.stl
prints/L_rear_thigh/L_rear_knee_inner_plate.stl
prints/neck/neck_rear_plate.stl
prints/R_front_thigh/R_front_knee_plate.stl
prints/R_rear_thigh/R_rear_knee_inner_tab.stl
prints/L_front_thigh/L_front_knee_inner_plate.stl
prints/L_rear_thigh/L_rear_knee_inner_tab.stl
prints/R_front_thigh/R_front_knee_inner_tab.stl
prints/R_rear_thigh/R_rear_knee_inner_plate.stl
prints/antlers/L_antler_tine_2.stl
prints/L_rear_thigh/L_rear_knee_cap.stl
prints/R_front_thigh/R_front_knee_cap.stl
prints/R_rear_thigh/R_rear_knee_cap.stl
prints/head/L_eye_pupil.stl
prints/antlers/R_antler_beam.stl
prints/body/R_rear_hip_boss.stl
prints/antlers/R_antler_tine_1.stl
prints/antlers/R_antler_burr.stl
prints/body/keel_rear_disc.stl
prints/body/L_rear_hip_boss.stl
prints/body/L_front_hip_boss.stl
prints/head/R_ear.stl
prints/head/R_inner_ear.stl
prints/head/L_eye_rim.stl
prints/head/R_eye_iris.stl
cad/reindeer.f3d
