meetsitaram/reindeer/prints/PRINTS.md

# Print files

87 printed parts from `spec/robot.py` (`python -I tools/export_prints.py`), PLA, in millimetres. Covers are their 2 mm wall. Not yet rounded, and not yet joined into print pieces with screw holes: phase 4 open items.

| link | part | colour | size mm | cm3 | g (PLA, solid) |
|---|---|---|---|---|---|
| body | body | #B87333 | 132 x 85 x 52 | 30.0 | 37.2 |
| body | bib | #F3EFE6 | 34 x 24 x 12 | 3.8 | 4.8 |
| body | tail | #B87333 | 26 x 18 x 16 | 2.0 | 2.5 |
| body | tail tip | #F3EFE6 | 14 x 12 x 12 | 1.1 | 1.3 |
| body | keel | #3A3D42 | 104 x 10 x 5 | 5.2 | 6.4 |
| body | keel front disc | #3A3D42 | 21 x 21 x 5 | 1.7 | 2.1 |
| body | keel rear disc | #3A3D42 | 21 x 21 x 5 | 1.7 | 2.1 |
| body | neck cradle floor | #3A3D42 | 27 x 23 x 3 | 1.5 | 1.9 |
| body | neck cradle back | #3A3D42 | 23 x 13 x 3 | 0.9 | 1.1 |
| body | battery post | #3A3D42 | 15 x 5 x 4 | 0.3 | 0.4 |
| body | battery tray | #3A3D42 | 46 x 36 x 2 | 2.5 | 3.1 |
| body | L front hip boss | #B87333 | 15 x 15 x 10 | 1.7 | 2.1 |
| body | L rear hip boss | #B87333 | 15 x 15 x 10 | 1.7 | 2.1 |
| body | R front hip boss | #B87333 | 15 x 15 x 10 | 1.7 | 2.1 |
| body | R rear hip boss | #B87333 | 15 x 15 x 10 | 1.7 | 2.1 |
| neck | neck horn plate | #B87333 | 32 x 20 x 3 | 1.9 | 2.4 |
| neck | neck rear plate | #B87333 | 32 x 20 x 3 | 1.9 | 2.4 |
| neck | neck bridge | #B87333 | 35 x 20 x 3 | 2.4 | 3.0 |
| neck | neck yaw seat | #B87333 | 22 x 17 x 3 | 1.3 | 1.6 |
| yawlink | yaw plate | #3A3D42 | 36 x 31 x 3 | 3.3 | 4.1 |
| yawlink | roll rear wall | #3A3D42 | 24 x 20 x 3 | 1.4 | 1.8 |
| head | cranium | #B87333 | 106 x 101 x 78 | 42.1 | 52.2 |
| head | muzzle | #F3EFE6 | 49 x 46 x 24 | 3.3 | 4.0 |
| head | nose | #17542E | 18 x 14 x 12 | 1.5 | 1.9 |
| head | L eye rim | #F3EFE6 | 31 x 30 x 17 | 3.3 | 4.1 |
| head | L eye iris | #1BA05A | 25 x 25 x 15 | 2.2 | 2.8 |
| head | L eye pupil | #08090B | 17 x 17 x 11 | 1.0 | 1.2 |
| head | L ear | #B87333 | 44 x 40 x 6 | 5.8 | 7.2 |
| head | L inner ear | #1F8A3C | 31 x 30 x 1 | 0.6 | 0.7 |
| head | head bracket | #3A3D42 | 27 x 23 x 3 | 1.9 | 2.3 |
| head | head face post | #3A3D42 | 48 x 10 x 6 | 2.8 | 3.5 |
| head | jaw cradle | #3A3D42 | 33 x 23 x 2 | 1.9 | 2.3 |
| head | jaw cradle post | #3A3D42 | 14 x 8 x 6 | 0.6 | 0.8 |
| head | antler cradle | #3A3D42 | 34 x 23 x 2 | 1.9 | 2.4 |
| head | antler cradle post | #3A3D42 | 9 x 6 x 4 | 0.2 | 0.3 |
| head | R eye rim | #F3EFE6 | 31 x 30 x 17 | 3.3 | 4.1 |
| head | R eye iris | #1BA05A | 25 x 25 x 15 | 2.2 | 2.8 |
| head | R eye pupil | #08090B | 17 x 17 x 11 | 1.0 | 1.2 |
| head | R ear | #B87333 | 44 x 40 x 6 | 5.8 | 7.2 |
| head | R inner ear | #1F8A3C | 31 x 30 x 1 | 0.6 | 0.7 |
| jaw | L jaw plate | #F3EFE6 | 33 x 22 x 3 | 1.4 | 1.8 |
| jaw | jaw | #F3EFE6 | 41 x 38 x 12 | 5.2 | 6.4 |
| jaw | tongue | #B8303A | 22 x 19 x 2 | 0.5 | 0.6 |
| jaw | R jaw plate | #F3EFE6 | 33 x 22 x 3 | 1.4 | 1.8 |
| antlers | antler horn plate | #3A3D42 | 26 x 18 x 3 | 1.0 | 1.2 |
| antlers | antler bar arm | #3A3D42 | 34 x 29 x 4 | 1.0 | 1.2 |
| antlers | antler bar | #3A3D42 | 36 x 30 x 6 | 6.5 | 8.0 |
| antlers | L antler beam | #1F8A3C | 76 x 33 x 28 | 12.0 | 14.9 |
| antlers | L antler tine 1 | #1F8A3C | 35 x 30 x 15 | 4.2 | 5.2 |
| antlers | L antler tine 2 | #1F8A3C | 34 x 30 x 13 | 3.8 | 4.8 |
| antlers | L antler burr | #7A4A22 | 28 x 20 x 6 | 1.3 | 1.6 |
| antlers | R antler beam | #C42630 | 76 x 33 x 28 | 12.0 | 14.9 |
| antlers | R antler tine 1 | #C42630 | 35 x 30 x 15 | 4.2 | 5.2 |
| antlers | R antler tine 2 | #C42630 | 34 x 30 x 13 | 3.8 | 4.8 |
| antlers | R antler burr | #7A4A22 | 28 x 20 x 6 | 1.3 | 1.6 |
| L_front_thigh | L front thigh | #B87333 | 40 x 35 x 28 | 7.7 | 9.6 |
| L_front_thigh | L front knee plate | #B87333 | 42 x 21 x 3 | 2.3 | 2.8 |
| L_front_thigh | L front knee outer tab | #B87333 | 12 x 6 x 2 | 0.2 | 0.2 |
| L_front_thigh | L front knee inner plate | #B87333 | 34 x 21 x 2 | 1.2 | 1.5 |
| L_front_thigh | L front knee inner tab | #B87333 | 12 x 6 x 3 | 0.2 | 0.3 |
| L_front_thigh | L front knee cap | #B87333 | 23 x 23 x 2 | 0.8 | 1.0 |
| L_front_shin | L front shin | #B87333 | 42 x 34 x 28 | 9.3 | 11.6 |
| L_front_shin | L front hoof | #C42630 | 39 x 31 x 18 | 17.2 | 21.4 |
| L_rear_thigh | L rear thigh | #B87333 | 40 x 35 x 28 | 7.7 | 9.6 |
| L_rear_thigh | L rear knee plate | #B87333 | 42 x 21 x 3 | 2.3 | 2.8 |
| L_rear_thigh | L rear knee outer tab | #B87333 | 12 x 6 x 2 | 0.2 | 0.2 |
| L_rear_thigh | L rear knee inner plate | #B87333 | 34 x 21 x 2 | 1.2 | 1.5 |
| L_rear_thigh | L rear knee inner tab | #B87333 | 12 x 6 x 3 | 0.2 | 0.3 |
| L_rear_thigh | L rear knee cap | #B87333 | 23 x 23 x 2 | 0.8 | 1.0 |
| L_rear_shin | L rear shin | #B87333 | 42 x 34 x 28 | 9.3 | 11.6 |
| L_rear_shin | L rear hoof | #1F8A3C | 39 x 31 x 18 | 17.2 | 21.4 |
| R_front_thigh | R front thigh | #B87333 | 40 x 35 x 28 | 7.7 | 9.6 |
| R_front_thigh | R front knee plate | #B87333 | 42 x 21 x 3 | 2.3 | 2.8 |
| R_front_thigh | R front knee outer tab | #B87333 | 12 x 6 x 2 | 0.2 | 0.2 |
| R_front_thigh | R front knee inner plate | #B87333 | 34 x 21 x 2 | 1.2 | 1.5 |
| R_front_thigh | R front knee inner tab | #B87333 | 12 x 6 x 3 | 0.2 | 0.3 |
| R_front_thigh | R front knee cap | #B87333 | 23 x 23 x 2 | 0.8 | 1.0 |
| R_front_shin | R front shin | #B87333 | 42 x 34 x 28 | 9.3 | 11.6 |
| R_front_shin | R front hoof | #1F8A3C | 39 x 31 x 18 | 17.2 | 21.4 |
| R_rear_thigh | R rear thigh | #B87333 | 40 x 35 x 28 | 7.7 | 9.6 |
| R_rear_thigh | R rear knee plate | #B87333 | 42 x 21 x 3 | 2.3 | 2.8 |
| R_rear_thigh | R rear knee outer tab | #B87333 | 12 x 6 x 2 | 0.2 | 0.2 |
| R_rear_thigh | R rear knee inner plate | #B87333 | 34 x 21 x 2 | 1.2 | 1.5 |
| R_rear_thigh | R rear knee inner tab | #B87333 | 12 x 6 x 3 | 0.2 | 0.3 |
| R_rear_thigh | R rear knee cap | #B87333 | 23 x 23 x 2 | 0.8 | 1.0 |
| R_rear_shin | R rear shin | #B87333 | 42 x 34 x 28 | 9.3 | 11.6 |
| R_rear_shin | R rear hoof | #C42630 | 39 x 31 x 18 | 17.2 | 21.4 |
