meetsitaram/reindeer/reports/assembly.md

# Build order and PATH (`tools/assembly.py`)

76 steps, 107 parts, **0 failing**. Covers that close round a servo are printed in halves (SPLIT). Legs are built on the bench, then brought in. Fit is not strength.

| | section | step | parts | path |
|---|---|---|---|---|
| PASS | The frame | Keel | Keel, Keel front disc, Keel rear disc | 30 mm along [-0.0, -0.0, -1.0] |
| PASS | The frame | Neck cradle | Neck cradle floor, Neck cradle back | 40 mm along [-0.0, -0.0, -1.0] |
| PASS | The frame | Battery tray | Battery post, Battery tray | 40 mm along [-0.0, -0.0, -1.0] |
| PASS | Electronics | Raspberry Pi Zero 2 W | Pi Zero 2 W | 40 mm along [0.0, 0.0, 1.0] |
| PASS | Electronics | Battery | Battery 2S, at most 44 x 30 x 8 mm | 40 mm along [-0.0, -0.0, -1.0] |
| PASS | Electronics | Bus board | Bus board | 40 mm along [-0.0, -0.0, -1.0] |
| PASS | Neck and head servos | Neck pitch servo | Neck pitch servo | 40 mm along [-0.0, -0.0, -1.0] |
| PASS | Neck and head servos | Neck bracket | Neck horn plate, Neck rear plate, Neck bridge, Neck yaw seat | 40 mm along [-0.0, -0.0, -1.0] |
| PASS | Neck and head servos | Head yaw servo | Head yaw servo | 40 mm along [-0.0, -0.0, -1.0] |
| PASS | Neck and head servos | Yaw plate | Yaw plate, Roll rear wall | 40 mm along [-0.0, -0.0, -1.0] |
| PASS | Neck and head servos | Head roll servo | Head roll servo | 40 mm along [-0.0, -0.0, -1.0] |
| PASS | Neck and head servos | Head bracket | Head bracket, Head face post | 40 mm along [-1.0, -0.0, -0.0] |
| PASS | Neck and head servos | Jaw servo | Jaw servo | 50 mm along [-1.0, -0.0, -0.0] |
| PASS | Neck and head servos | Jaw cradle | Jaw cradle, Jaw cradle post | 50 mm along [-1.0, -0.0, -0.0] |
| PASS | Neck and head servos | Antler cradle | Antler cradle, Antler cradle post | 40 mm along [-0.0, -1.0, -0.0] |
| PASS | Neck and head servos | Antler servo | Antlers servo | 40 mm along [-0.0, -1.0, -0.0] |
| PASS | Neck and head servos | Antler bar | Antler horn plate, Antler bar arm, Antler bar | 40 mm along [-0.0, -0.0, -1.0] |
| PASS | Body covers | Body, left half | Body left half | 60 mm along [-0.0, -1.0, -0.0] |
| PASS | Body covers | Body, right half | Body right half | 45 mm along [0.0, 1.0, 0.0] |
| PASS | Body covers | Bib | Bib | 40 mm along [-1.0, -0.0, -0.0] |
| PASS | Body covers | Tail | Tail, Tail tip | 40 mm along [1.0, 0.0, 0.0] |
| PASS | Left front leg | Hip servo | Left front hip servo | 30 mm along [-0.0, -0.0, -1.0] |
| PASS | Left front leg | Thigh | Left front thigh front half | 40 mm along [-1.0, -0.0, -0.0] |
| PASS | Left front leg | Thigh | Left front thigh back half | 40 mm along [1.0, 0.0, 0.0] |
| PASS | Left front leg | Knee servo | Left front knee servo | 40 mm along [0.0, 0.0, 1.0] |
| PASS | Left front leg | Shin | Left front shin front half | 40 mm along [-1.0, -0.0, -0.0] |
| PASS | Left front leg | Shin | Left front shin back half | 40 mm along [1.0, 0.0, 0.0] |
| PASS | Left front leg | Hoof | Left front hoof | 40 mm along [0.0, 0.0, 1.0] |
| PASS | Left front leg | Knee inner plate | Left front knee inner plate, Left front knee inner tab | 40 mm along [0.0, 1.0, 0.0] |
| PASS | Left front leg | Knee outer plate | Left front knee plate, Left front knee outer tab | 40 mm along [-0.0, -1.0, -0.0] |
| PASS | Left front leg | Knee cap | Left front knee cap | 40 mm along [-0.0, -1.0, -0.0] |
| PASS | Left front leg | Left front leg | Left front hip servo, Left front thigh front half, Left front thigh back half, Left front knee servo, Left front shin front half, Left front shin back half ... | 200 mm along [0.0, 0.0, 1.0] |
| PASS | Left rear leg | Hip servo | Left rear hip servo | 30 mm along [-0.0, -0.0, -1.0] |
| PASS | Left rear leg | Thigh | Left rear thigh front half | 40 mm along [-1.0, -0.0, -0.0] |
| PASS | Left rear leg | Thigh | Left rear thigh back half | 40 mm along [1.0, 0.0, 0.0] |
| PASS | Left rear leg | Knee servo | Left rear knee servo | 40 mm along [0.0, 0.0, 1.0] |
| PASS | Left rear leg | Shin | Left rear shin front half | 40 mm along [-1.0, -0.0, -0.0] |
| PASS | Left rear leg | Shin | Left rear shin back half | 40 mm along [1.0, 0.0, 0.0] |
| PASS | Left rear leg | Hoof | Left rear hoof | 40 mm along [0.0, 0.0, 1.0] |
| PASS | Left rear leg | Knee inner plate | Left rear knee inner plate, Left rear knee inner tab | 40 mm along [0.0, 1.0, 0.0] |
| PASS | Left rear leg | Knee outer plate | Left rear knee plate, Left rear knee outer tab | 40 mm along [-0.0, -1.0, -0.0] |
| PASS | Left rear leg | Knee cap | Left rear knee cap | 40 mm along [-0.0, -1.0, -0.0] |
| PASS | Left rear leg | Left rear leg | Left rear hip servo, Left rear thigh front half, Left rear thigh back half, Left rear knee servo, Left rear shin front half, Left rear shin back half ... | 200 mm along [0.0, 0.0, 1.0] |
| PASS | Right front leg | Hip servo | Right front hip servo | 30 mm along [-0.0, -0.0, -1.0] |
| PASS | Right front leg | Thigh | Right front thigh front half | 40 mm along [-1.0, -0.0, -0.0] |
| PASS | Right front leg | Thigh | Right front thigh back half | 40 mm along [1.0, 0.0, 0.0] |
| PASS | Right front leg | Knee servo | Right front knee servo | 40 mm along [0.0, 0.0, 1.0] |
| PASS | Right front leg | Shin | Right front shin front half | 40 mm along [-1.0, -0.0, -0.0] |
| PASS | Right front leg | Shin | Right front shin back half | 40 mm along [1.0, 0.0, 0.0] |
| PASS | Right front leg | Hoof | Right front hoof | 40 mm along [0.0, 0.0, 1.0] |
| PASS | Right front leg | Knee inner plate | Right front knee inner plate, Right front knee inner tab | 40 mm along [-0.0, -1.0, -0.0] |
| PASS | Right front leg | Knee outer plate | Right front knee plate, Right front knee outer tab | 40 mm along [0.0, 1.0, 0.0] |
| PASS | Right front leg | Knee cap | Right front knee cap | 40 mm along [0.0, 1.0, 0.0] |
| PASS | Right front leg | Right front leg | Right front hip servo, Right front thigh front half, Right front thigh back half, Right front knee servo, Right front shin front half, Right front shin back half ... | 200 mm along [0.0, 0.0, 1.0] |
| PASS | Right rear leg | Hip servo | Right rear hip servo | 30 mm along [-0.0, -0.0, -1.0] |
| PASS | Right rear leg | Thigh | Right rear thigh front half | 40 mm along [-1.0, -0.0, -0.0] |
| PASS | Right rear leg | Thigh | Right rear thigh back half | 40 mm along [1.0, 0.0, 0.0] |
| PASS | Right rear leg | Knee servo | Right rear knee servo | 40 mm along [0.0, 0.0, 1.0] |
| PASS | Right rear leg | Shin | Right rear shin front half | 40 mm along [-1.0, -0.0, -0.0] |
| PASS | Right rear leg | Shin | Right rear shin back half | 40 mm along [1.0, 0.0, 0.0] |
| PASS | Right rear leg | Hoof | Right rear hoof | 40 mm along [0.0, 0.0, 1.0] |
| PASS | Right rear leg | Knee inner plate | Right rear knee inner plate, Right rear knee inner tab | 40 mm along [-0.0, -1.0, -0.0] |
| PASS | Right rear leg | Knee outer plate | Right rear knee plate, Right rear knee outer tab | 40 mm along [0.0, 1.0, 0.0] |
| PASS | Right rear leg | Knee cap | Right rear knee cap | 40 mm along [0.0, 1.0, 0.0] |
| PASS | Right rear leg | Right rear leg | Right rear hip servo, Right rear thigh front half, Right rear thigh back half, Right rear knee servo, Right rear shin front half, Right rear shin back half ... | 200 mm along [0.0, 0.0, 1.0] |
| PASS | Head | Left jaw plate | Left jaw plate | 45 mm along [-0.0, -1.0, -0.0] |
| PASS | Head | Right jaw plate | Right jaw plate | 40 mm along [0.0, 1.0, 0.0] |
| PASS | Head | Head, left half | Cranium left half | 60 mm along [-0.0, -1.0, -0.0] |
| PASS | Head | Head, right half | Cranium right half | 55 mm along [0.0, 1.0, 0.0] |
| PASS | Head | Jaw | Jaw | 55 mm along [-0.96, 0.0, 0.29] |
| PASS | Head | Nose | Nose | 40 mm along [-1.0, -0.0, -0.0] |
| PASS | Head | Eyes | Left eye rim, Left eye iris, Left eye pupil, Right eye rim, Right eye iris, Right eye pupil | 45 mm along [-1.0, -0.0, -0.0] |
| PASS | Head | Ears | Left ear, Left inner ear, Right ear, Right inner ear | 45 mm along [-0.0, -0.0, -1.0] |
| PASS | Head | Antlers | Left antler beam, Left antler tine 1, Left antler tine 2, Right antler beam, Right antler tine 1, Right antler tine 2 | 40 mm along [-0.0, -0.0, -1.0] |
| PASS | Head | Left antler burr | Left antler burr | 100 mm along [-1.0, -0.0, -0.0] |
| PASS | Head | Right antler burr | Right antler burr | 100 mm along [-1.0, -0.0, -0.0] |
| PASS | ALL | every part fitted once | | 107 fitted of 107 |
