meetsitaram/reindeer/reports/build_test.png

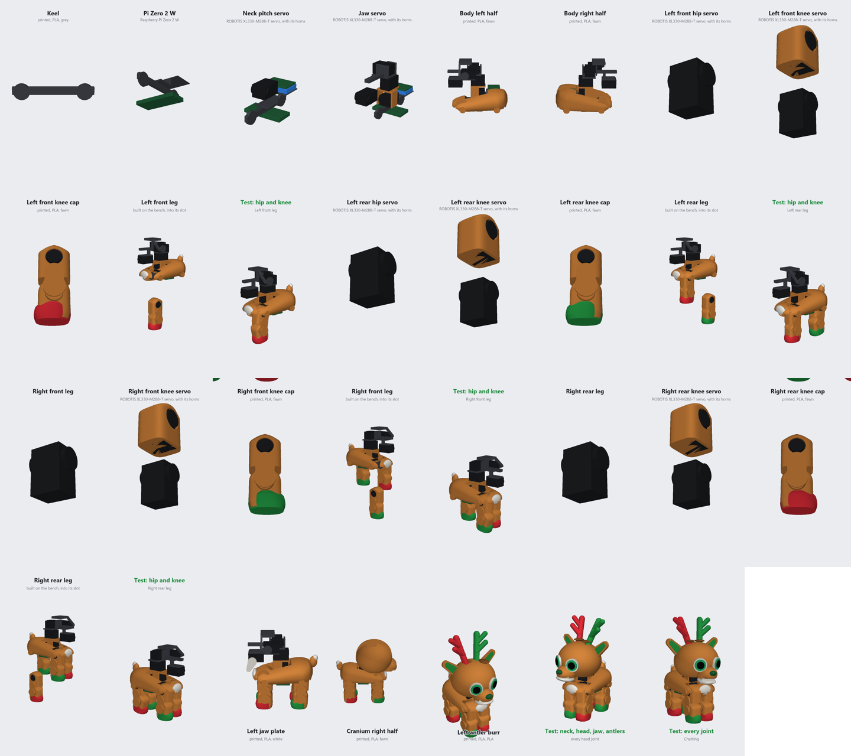
reports/build_test.png
