meetsitaram/reindeer/reports/reveal_test.png

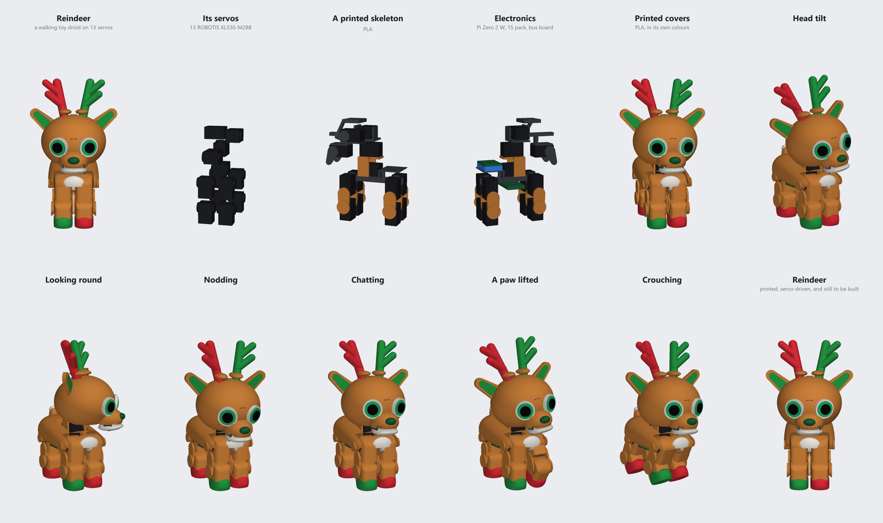
reports/reveal_test.png
