meetsitaram/reindeer/LESSONS.md

# Lessons (reindeer)

| when | issue | cause | fix |
|---|---|---|---|
| round 1 | The chest stopped short of the chin, with dark neck showing; the chest was cut open | The leg pockets were sized for the case's whole sweep | Pockets only the leg's own round top and slot |
| round 3 | A front leg's cover crossed its own servo | A superellipse with n 2.4 cuts a box's corners | n 6 round the case |
| round 4 | The balance check let only the hooves carry the body | The floor threshold equalled the body's bottom height, and rigid parts were ignored | All parts within 2 mm |
| round 4 | The mass was 32 g high | Two shells printed as one were each counted with a whole wall | `merge_into` |
| round 5 | The reference walked | A second video | A quadruped, 2 servos a leg, each riding in its own segment |
| round 6 | Knee plates joined nothing | They stood 0.5 mm off the thigh's walls | Tabs into the walls, above the shin's round top |
| round 7 | The bib sat over both front thighs | Decals were in no collision check | A decal/other-link static check, proven with `--bad decal` |
| Fusion | `ellipsoid()` raised in Direct mode | figlib named a feature that Direct mode returns as None | Guarded |
