meetsitaram/reindeer/(commit log)

2026-11-06 A walking reindeer from one spec, and the droid-from-spec skill's first test on something that isn't a duck
    spec/robot.py: a 24 cm quadruped on 11 XL330s (hip and knee a leg, each servo riding in its own
    segment; neck pitch, head yaw, head roll), its look measured from the user's two videos. Tools forked
    from duck-droids where they were generic (geom, checks, mass_model, render_pose, figlib) and written
    for it where they weren't (compare against video frames, sim_stand, a lean Fusion builder). 108 checks,
    0 failing; all 10 broken designs caught; gate 2 passes; the Fusion model is in the hub.
    SKILL_TEST.md: each instruction used, whether it worked as written, and what changed in the skill.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
2026-11-06 Round 8: a mouth that opens, both antlers on one servo, a rounder reindeer, and its build-ready papers
    The user: "looks a bit ugly", "no mouth action which is important", "make the two antlers move together
    with another servo". A jaw XL330 low in the face opens the lower muzzle 0.45 rad; one XL330 beside the
    roll servo nods both antlers on a bar, out through slots under dark burrs. Legs rounder (n 4.5), fawn hubs
    and knee caps, domed hooves, a fuller body, one clean bib. 13 servos, 690 g; 128 checks, 0 failing; all
    10 broken designs caught; sim_stand passes.
    Fusion rebuilt (hub version), STEP (127 solids, matching its bodies) and .f3d exported; 87 print files;
    BOM.md and docs/WIRING.md from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
    [L_antler_beam.stl, L_antler_burr.stl, L_antler_tine_1.stl, L_antler_tine_2.stl, L_ear.stl, L_eye_iris.stl, L_eye_pupil.stl, L_eye_rim.stl]
2026-11-06 A tuned trot in MuJoCo (20-minute CPU search) with RL prepared to train elsewhere, and clips of the reindeer standing up, sitting, walking and its moves; the detail pass
    The walk is a parametric gait, said as such (0.20 m/s in the clip, a servo at stall 36 % of the time):
    sim/TRAINING.md sets up the real policy for a GPU machine. Jaw plates white and the face post off the
    surface (round 8's close look).
2026-11-06 The build order as data (76 steps, PATH check with its broken case), the 30 s reveal, the build video and the parts layout
    The order found that no one-piece cover can close round a servo: covers go on in halves (the spec still
    draws them whole: an open item). Gates 2, 3 and 4 pass their scripted parts.
2026-11-06 Print files and reports after the round-8 face post and jaw plate fix
    [head_face_post.stl]
